GAULAvionique/Cetautomatix/Hardware/Composants/7447715330/WE-PD_1245.step

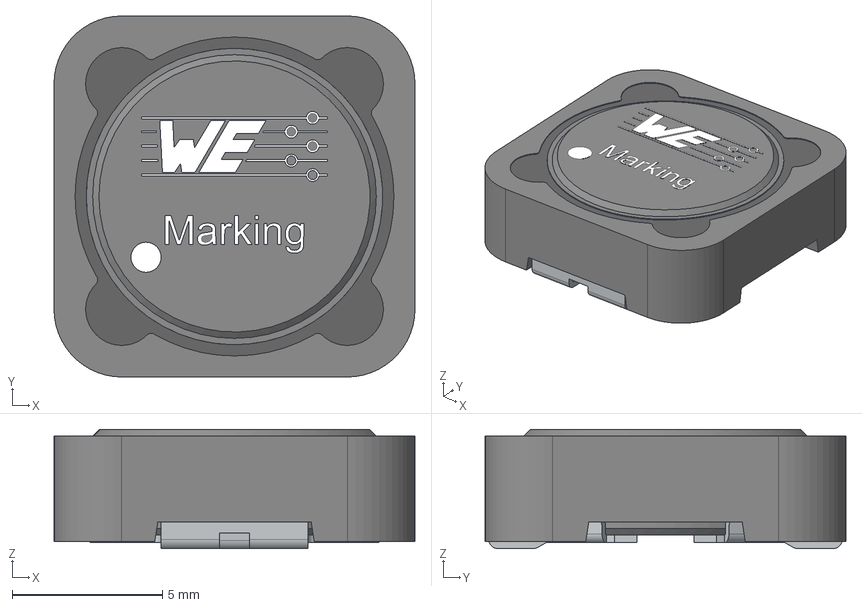
[picture p1: CAD file, 2026-01-22]
Hardware/Composants/7447715330/WE-PD_1245.step
12.0 x 12.0 x 3.96 mm
Core
ShieldRing
Glue
Leadframe
