GAULAvionique/Cetautomatix/Hardware/Composants/GT17HN_4DP_2H_A__56_/GT17HN_4DP_2H_A__56_.stp

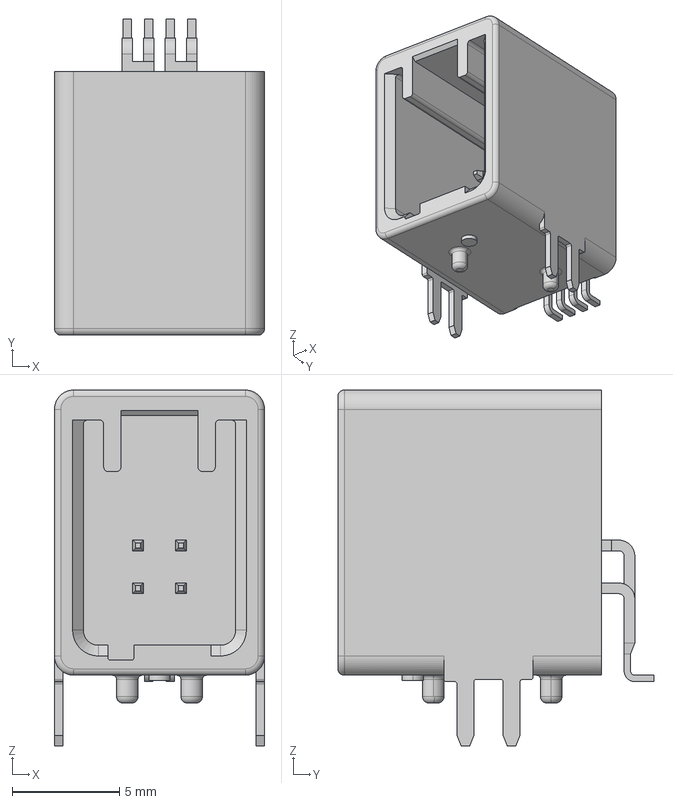
[picture p2: CAD file, 2026-01-23]
Hardware/Composants/GT17HN_4DP_2H_A__56_/GT17HN_4DP_2H_A__56_.stp
9.80 x 14.8 x 16.6 mm
