GAULAvionique/Cetautomatix/Hardware/Composants/LM2673SX-12_NOPB/LM2673SX-12_NOPB.step

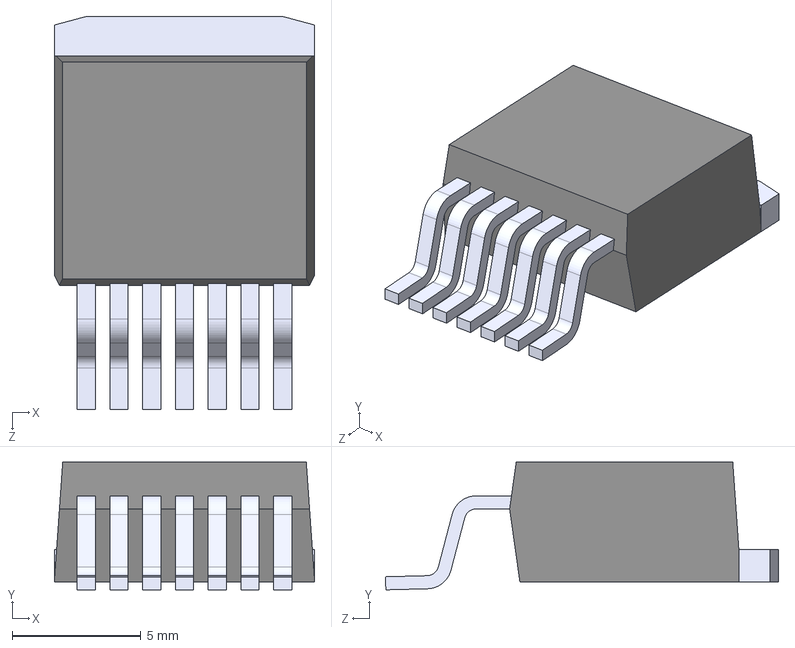
[picture p3: CAD file, 2026-01-25]
Hardware/Composants/LM2673SX-12_NOPB/LM2673SX-12_NOPB.step
10.1 x 4.95 x 15.2 mm
