GAULAvionique/Cetautomatix/Hardware/Composants/MBRS540T3G/MBRS540T3G.step

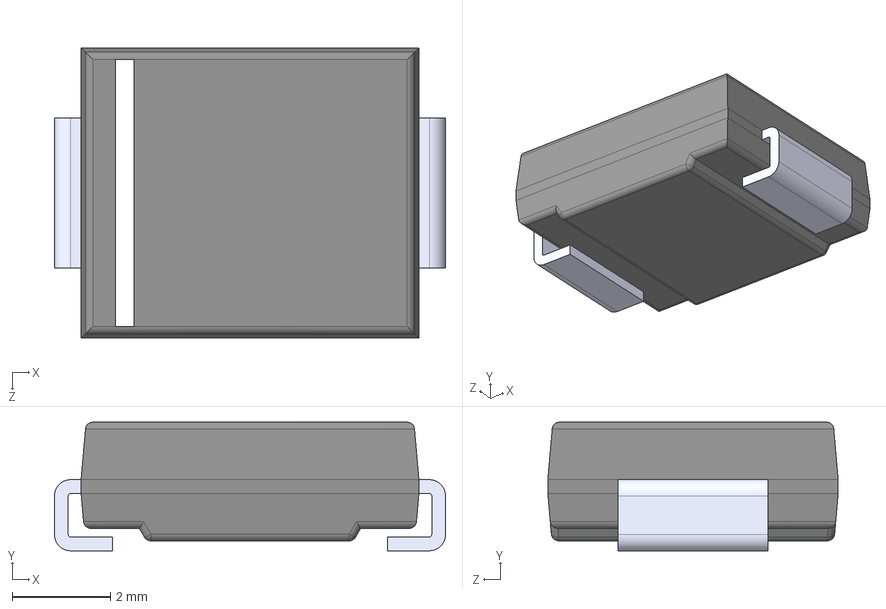
[picture p4: CAD file, 2026-01-26]
Hardware/Composants/MBRS540T3G/MBRS540T3G.step
7.95 x 2.62 x 5.91 mm
