GAULAvionique/Cetautomatix/Hardware/Composants/PJ-037BH/PJ-037BH.step

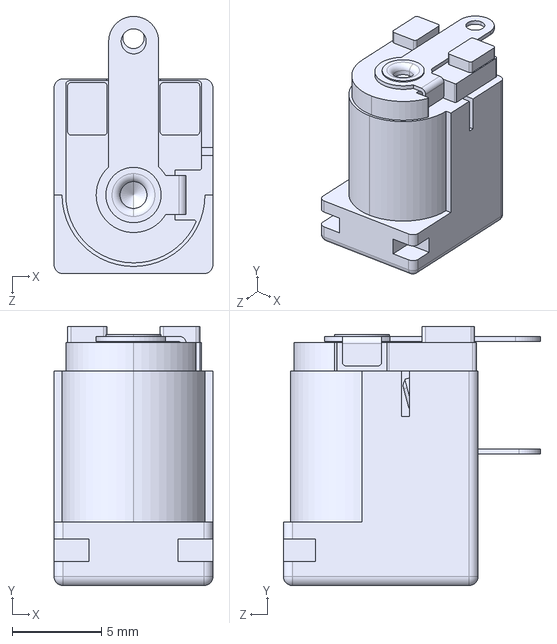
[picture p5: CAD file, 2026-03-07]
Hardware/Composants/PJ-037BH/PJ-037BH.step
8.90 x 14.5 x 14.4 mm
