GAULAvionique/Cetautomatix/Hardware/PCB_GSE/Composants/mod3D/WE-XTAL_HC49.step

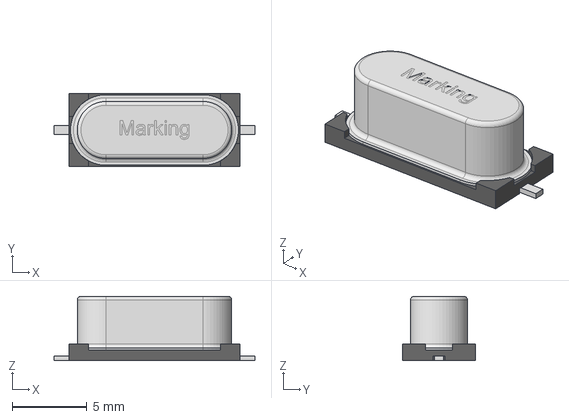
[picture p6: CAD file, 2026-03-09]
Hardware/PCB_GSE/Composants/mod3D/WE-XTAL_HC49.step
13.4 x 4.90 x 4.30 mm
Base
Housing
