GAULAvionique/Cetautomatix/Hardware/PCB_Moteur/Composants/mod3D/SM03B-GHS-TB.step

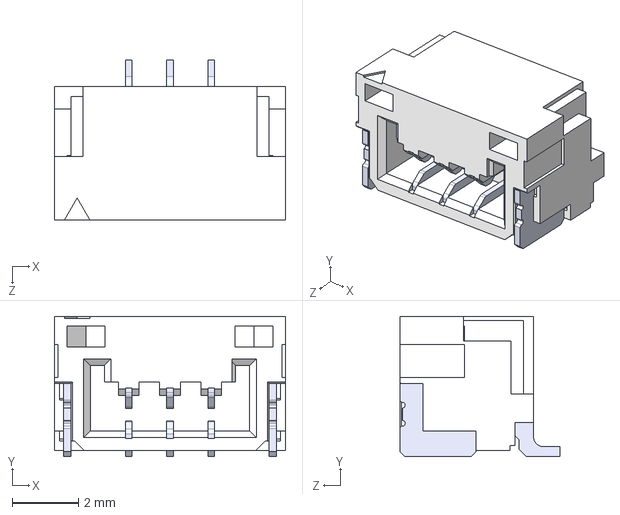
[picture p7: CAD file, 2026-03-08]
Hardware/PCB_Moteur/Composants/mod3D/SM03B-GHS-TB.step
7.00 x 4.25 x 4.85 mm
SMxB-GHS-TB_03
pin x 3
