GAULAvionique/Cetautomatix/Hardware/PCB_Moteur/Composants/mod3D/OSTVN04A150.STEP

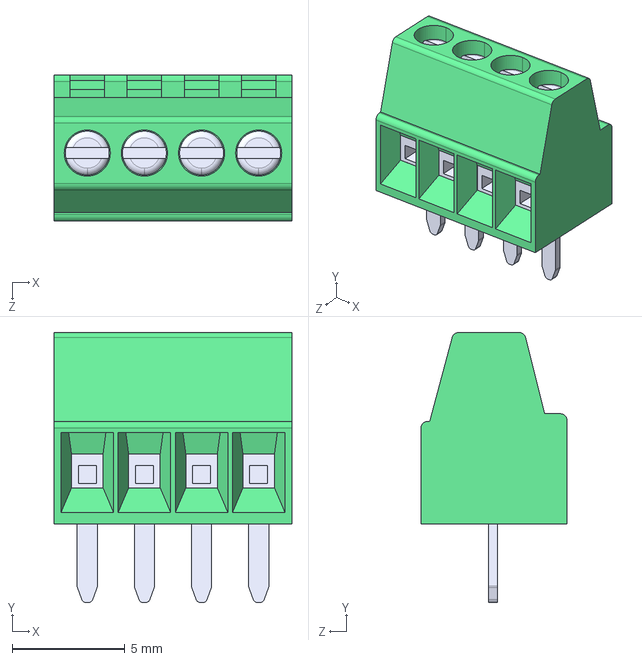
[picture p8: CAD file, 2026-03-06]
Hardware/PCB_Moteur/Composants/mod3D/OSTVN04A150.STEP
10.6 x 12.0 x 6.50 mm
