GAULAvionique/Cetautomatix/Hardware/PCB_GSE/Composants/mod3D/srr1208.stp

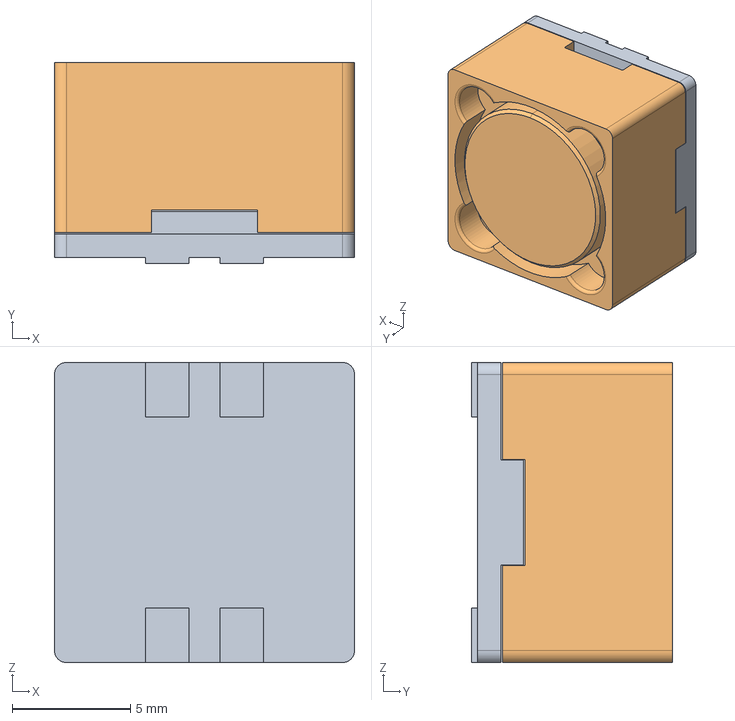
[picture p9: CAD file, 2026-02-07]
Hardware/PCB_GSE/Composants/mod3D/srr1208.stp
12.7 x 8.50 x 12.7 mm
