GAULAvionique/Cetautomatix/Hardware/PCB_GSE/Composants/mod3D/BM03B-GHS-TBT.STEP

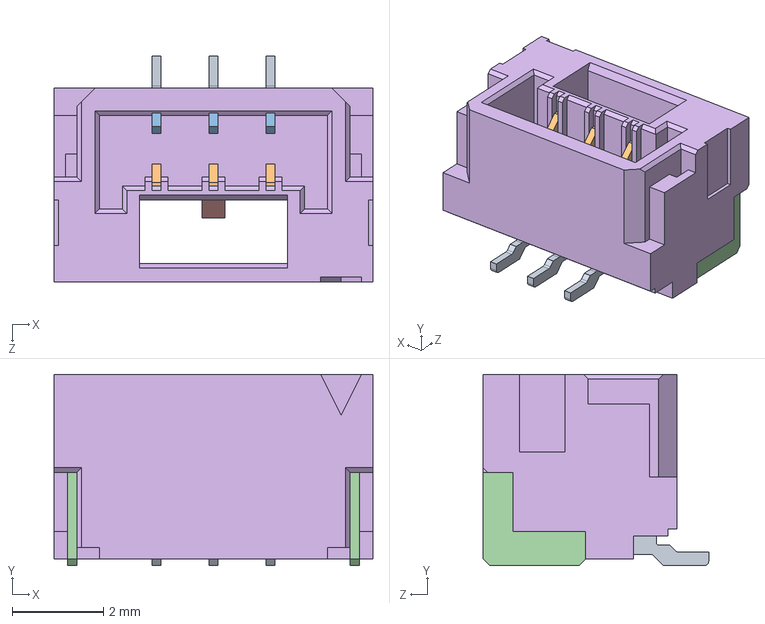
[picture p10: CAD file, 2026-01-21]
Hardware/PCB_GSE/Composants/mod3D/BM03B-GHS-TBT.STEP
7.00 x 4.20 x 4.95 mm
