GAULAvionique/Cetautomatix/Hardware/Composants/830050510/830050510.step

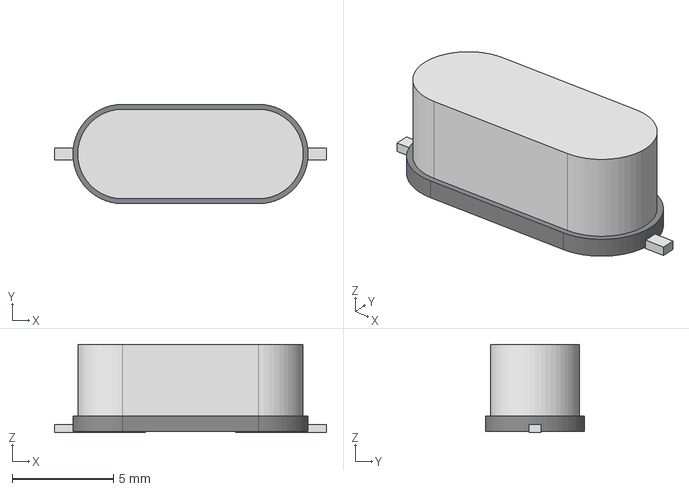
[picture p11: CAD file, 2026-02-06]
Hardware/Composants/830050510/830050510.step
13.4 x 4.90 x 4.34 mm
