GAULAvionique/Cetautomatix/Hardware/Composants/TLV75733PDBVR/TLV75733PDBVR.step

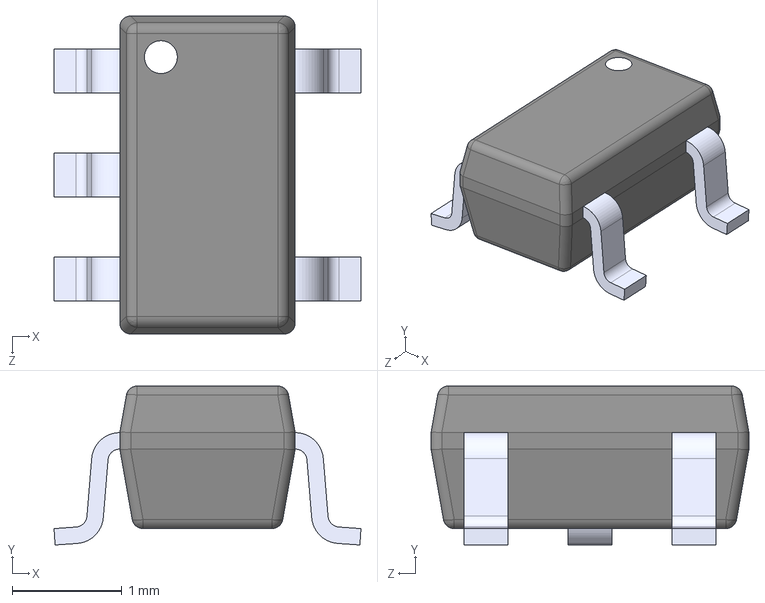
[picture p12: CAD file, 2026-01-27]
Hardware/Composants/TLV75733PDBVR/TLV75733PDBVR.step
2.80 x 1.45 x 2.90 mm
