GAULAvionique/Cetautomatix/Hardware/PCB_GSE/Composants/mod3D/640454-2.step

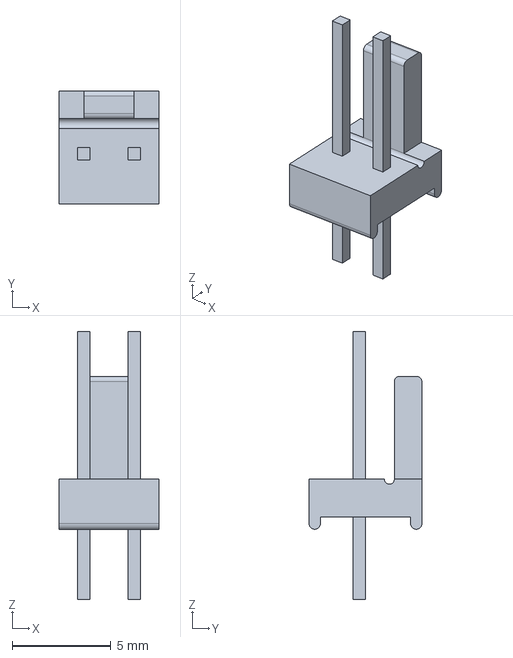
[picture p13: CAD file, 2026-01-19]
Hardware/PCB_GSE/Composants/mod3D/640454-2.step
5.08 x 5.72 x 13.6 mm
