GAULAvionique/Cetautomatix/Hardware/PCB_GSE/Composants/mod3D/2189890210.stp

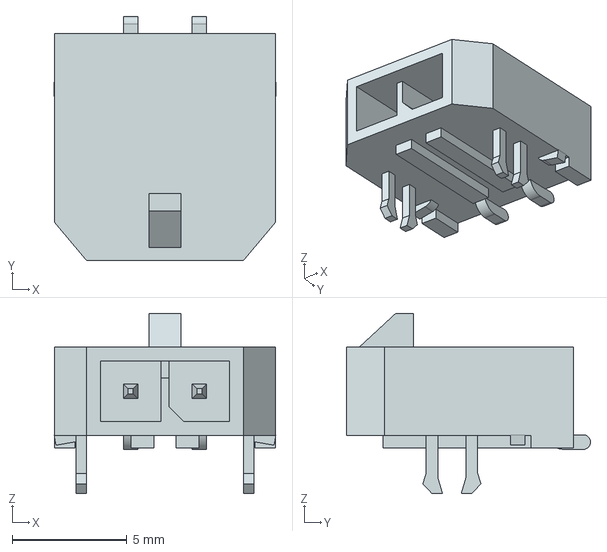
[picture p14: CAD file, 2026-01-19]
Hardware/PCB_GSE/Composants/mod3D/2189890210.stp
9.68 x 10.7 x 7.87 mm
