GAULAvionique/Cetautomatix/(list of files, drawings)

Other design files:
Hardware/PCB_Moteur/PCB_moteur.kicad_pcb.hierpcb.json
