GAULAvionique/Cetautomatix/Hardware/PCB_Moteur/PCB_moteur.kicad_pcb

## KiCad design Hardware/PCB_Moteur/PCB_moteur.kicad_pcb (2026-03-10)

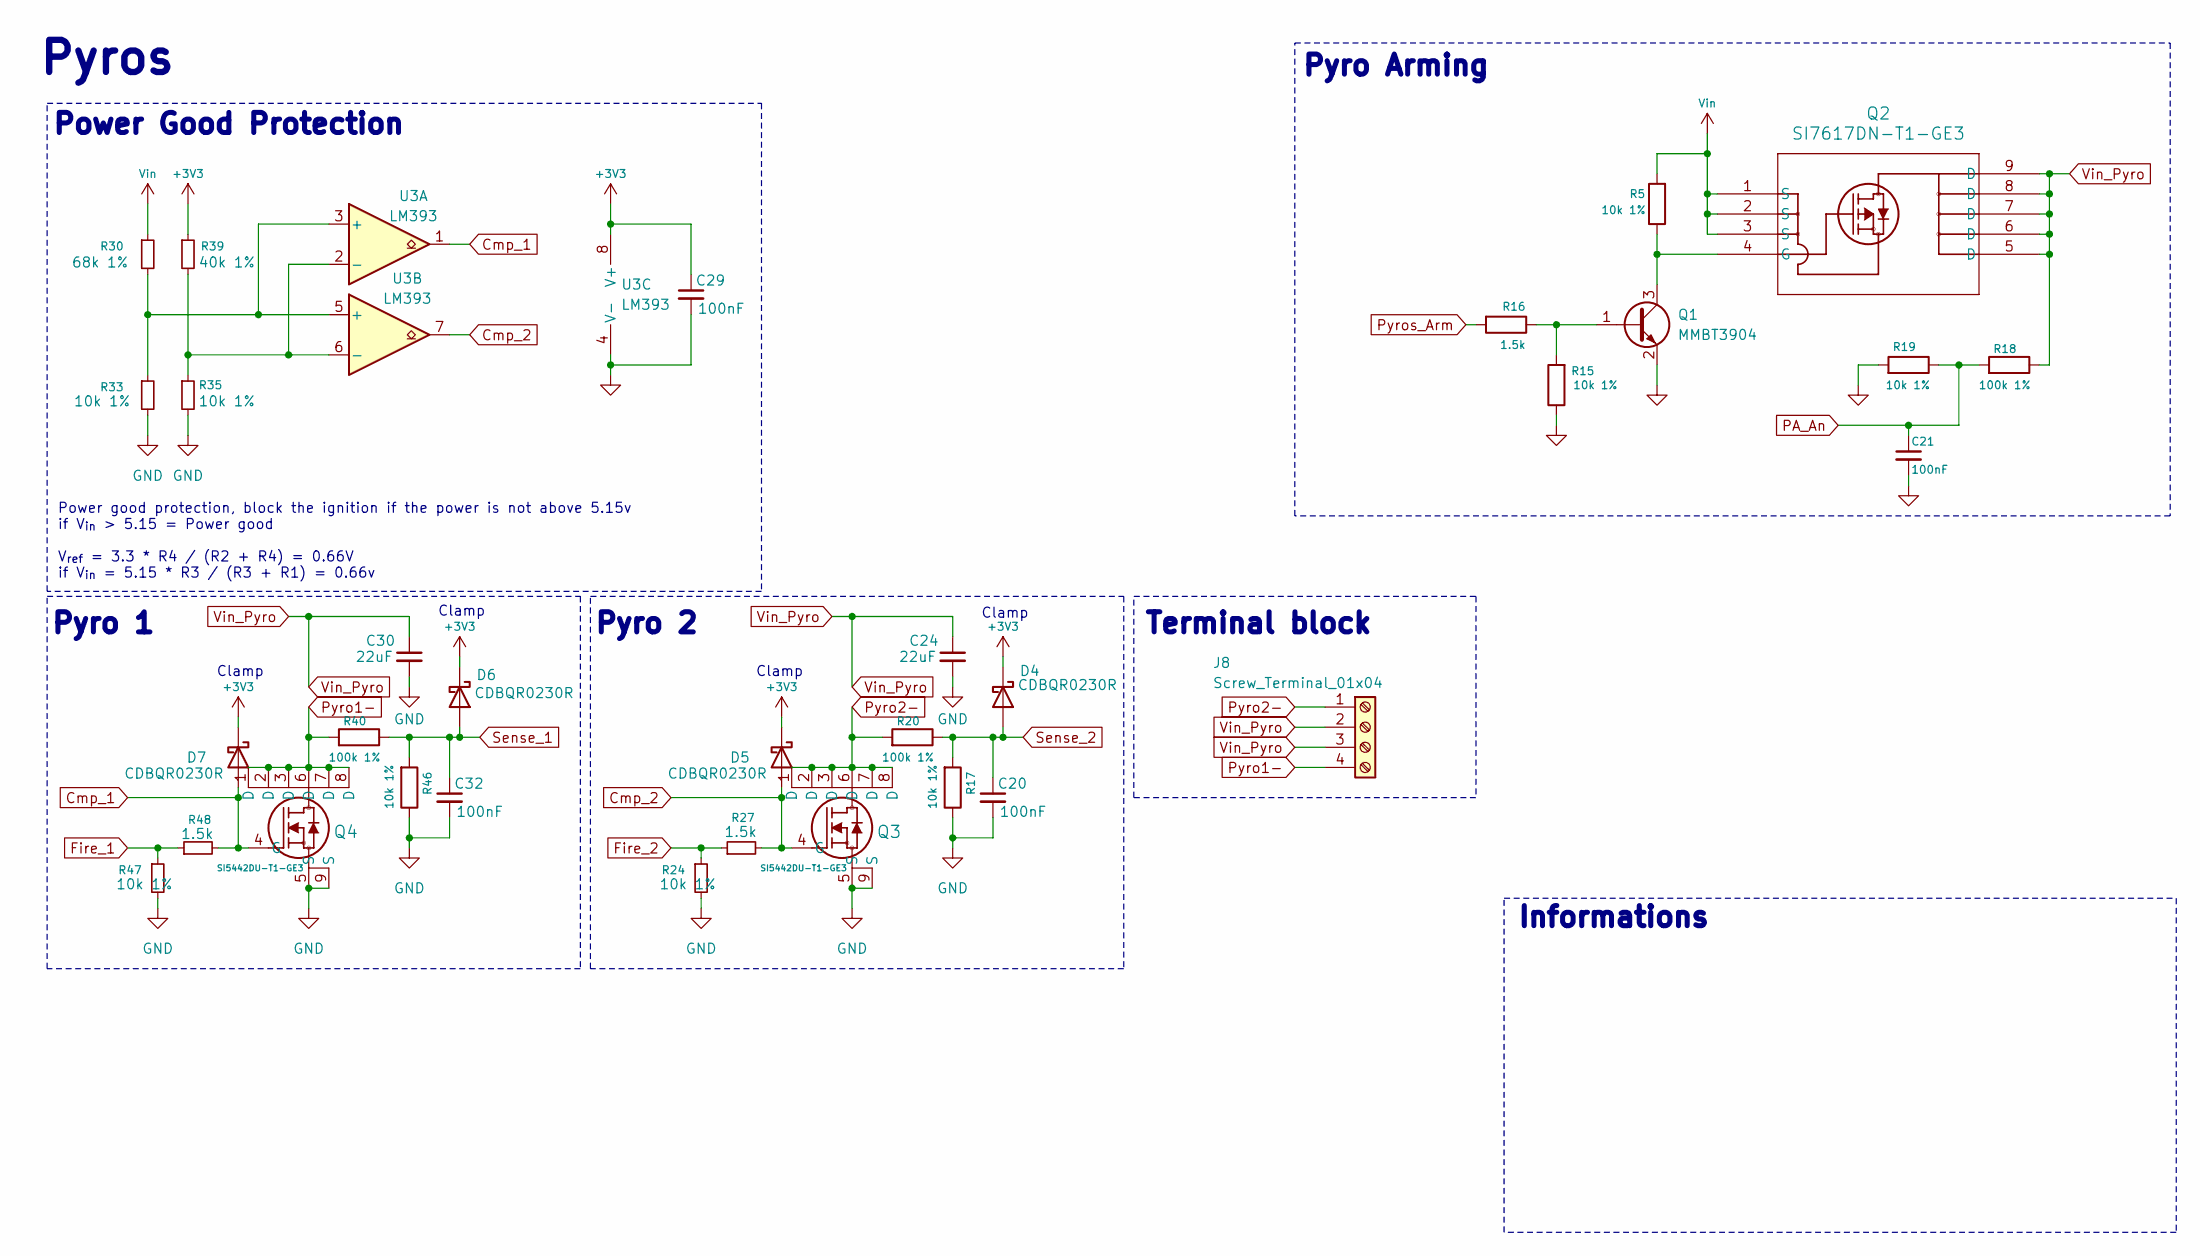
[picture p15: schematic Pyros.kicad_sch]

Parts:
C20, C21, C29, C32: 100nF; C_0805_2012Metric; Manufacturer_Part_Number C0805C104K5RACTU; DigiKey_Part_Number 399-C0805C104K5RACTUCT-ND
C24, C30: 22uF; C_0805_2012Metric; Manufacturer_Part_Number C2012X5R1V226M125AC; DigiKey_Part_Number 445-14428-1-ND
D4, D5, D6, D7: CDBQR0230R; D_0603_1608Metric; Manufacturer_Part_Number CD0603-B0340R; DigiKey_Part_Number CD0603-B0340RCT-ND
J8: Screw_Terminal_01x04; CONN_OSTVN04A150_OST; Manufacturer_Part_Number OSTVN04A150; DigiKey_Part_Number ED10563-ND
Q1: MMBT3904; SOT-23; Manufacturer_Part_Number MMBT3904LT1G; DigiKey_Part_Number MMBT3904LT1GOSCT-ND
Q2: SI7617DN-T1-GE3; POWERPAK_1212-8_VIS; Manufacturer_Part_Number SI7617DN-T1-GE3; DigiKey_Part_Number SI7617DN-T1-GE3CT-ND
Q3, Q4: SI5442DU-T1-GE3; SON_8DU-T1-GE3_VIS; Manufacturer_Part_Number SI5442DU-T1-GE3; DigiKey_Part_Number SI5442DU-T1-GE3CT-ND
R5, R15, R17, R19, R24, R33, R35, R46, R47: 10k 1%; R_0805_2012Metric; Manufacturer_Part_Number CRCW080510K0FKEA; DigiKey_Part_Number 541-10.0KCCT-ND
R16, R27, R48: 1.5k; R_0805_2012Metric; Manufacturer_Part_Number RC0805FR-071K5L; DigiKey_Part_Number 311-1.50KCRCT-ND
R18, R20, R40: 100k 1%; R_0805_2012Metric; Manufacturer_Part_Number RC0805FR-07100KL; DigiKey_Part_Number 311-100KCRCT-ND
R30: 68k 1%; R_0805_2012Metric; Manufacturer_Part_Number RMCF0805FT68K0; DigiKey_Part_Number RMCF0805FT68K0CT-ND
R39: 40k 1%; R_0805_2012Metric; Manufacturer_Part_Number CRCW080540K0FKEA; DigiKey_Part_Number 541-CRCW080540K0FKEACT-ND
U3: LM393; SOIC-8_3.9x4.9mm_P1.27mm; Manufacturer_Part_Number LM393DR; DigiKey_Part_Number 296-1015-1-ND

Connections:
3V3_Main: C29.1, D4.1 (K), D5.1 (K), D6.1 (K), D7.1 (K), R39.1, U3.8 (V+); also elsewhere on the board
Cmp_1: D7.2 (A), Q4.4 (G), R48.2, U3.1
Cmp_2: D5.2 (A), Q3.4 (G), R27.2, U3.7
Fire_1: R47.1, R48.1; also elsewhere on the board
Fire_2: R24.1, R27.1; also elsewhere on the board
GND: C20.2, C21.2, C24.2, C29.2, C30.2, C32.2, Q1.2 (E), Q3.5 (S), Q3.9 (S), Q4.5 (S), Q4.9 (S), R15.1, R17.1, R19.2, R24.2, R33.2, R35.2, R46.1, R47.2, U3.4 (V-); also elsewhere on the board
unnamed: Q1.1 (B), R15.2, R16.1
unnamed: Q1.3 (C), Q2.4 (G), R5.1
unnamed: R30.2, R33.1, U3.3 (+), U3.5 (+)
unnamed: R35.1, R39.2, U3.2 (-), U3.6 (-)
PA_An: C21.1, R18.2, R19.1; also elsewhere on the board
Pyro1-: J8.4, Q4.1 (D), Q4.2 (D), Q4.3 (D), Q4.6 (D), Q4.7 (D), Q4.8 (D), R40.2
Pyro2-: J8.1, Q3.1 (D), Q3.2 (D), Q3.3 (D), Q3.6 (D), Q3.7 (D), Q3.8 (D), R20.2
Pyros_Arm: R16.2; also elsewhere on the board
Sense_1: C32.1, D6.2 (A), R40.1, R46.2; also elsewhere on the board
Sense_2: C20.1, D4.2 (A), R17.2, R20.1; also elsewhere on the board
VIN_Filtered: Q2.1 (S), Q2.2 (S), Q2.3 (S), R5.2, R30.1; also elsewhere on the board
Vin_Pyro: C24.1, C30.1, J8.2, J8.3, Q2.5 (D), Q2.6 (D), Q2.7 (D), Q2.8 (D), Q2.9 (D), R18.1

Notes on the sheet:
Power good protection, block the ignition if the power is not above 5.15v if V_{in} > 5.15 = Power good V_{ref} = 3.3 * R4 / (R2 + R4) = 0.66V if V_{in} = 5.15 * R3 / (R3 + R1) = 0.66v
Clamp
Pyro 1
Terminal block
Pyro Arming
Pyros
Informations
Power Good Protection
Pyro 2

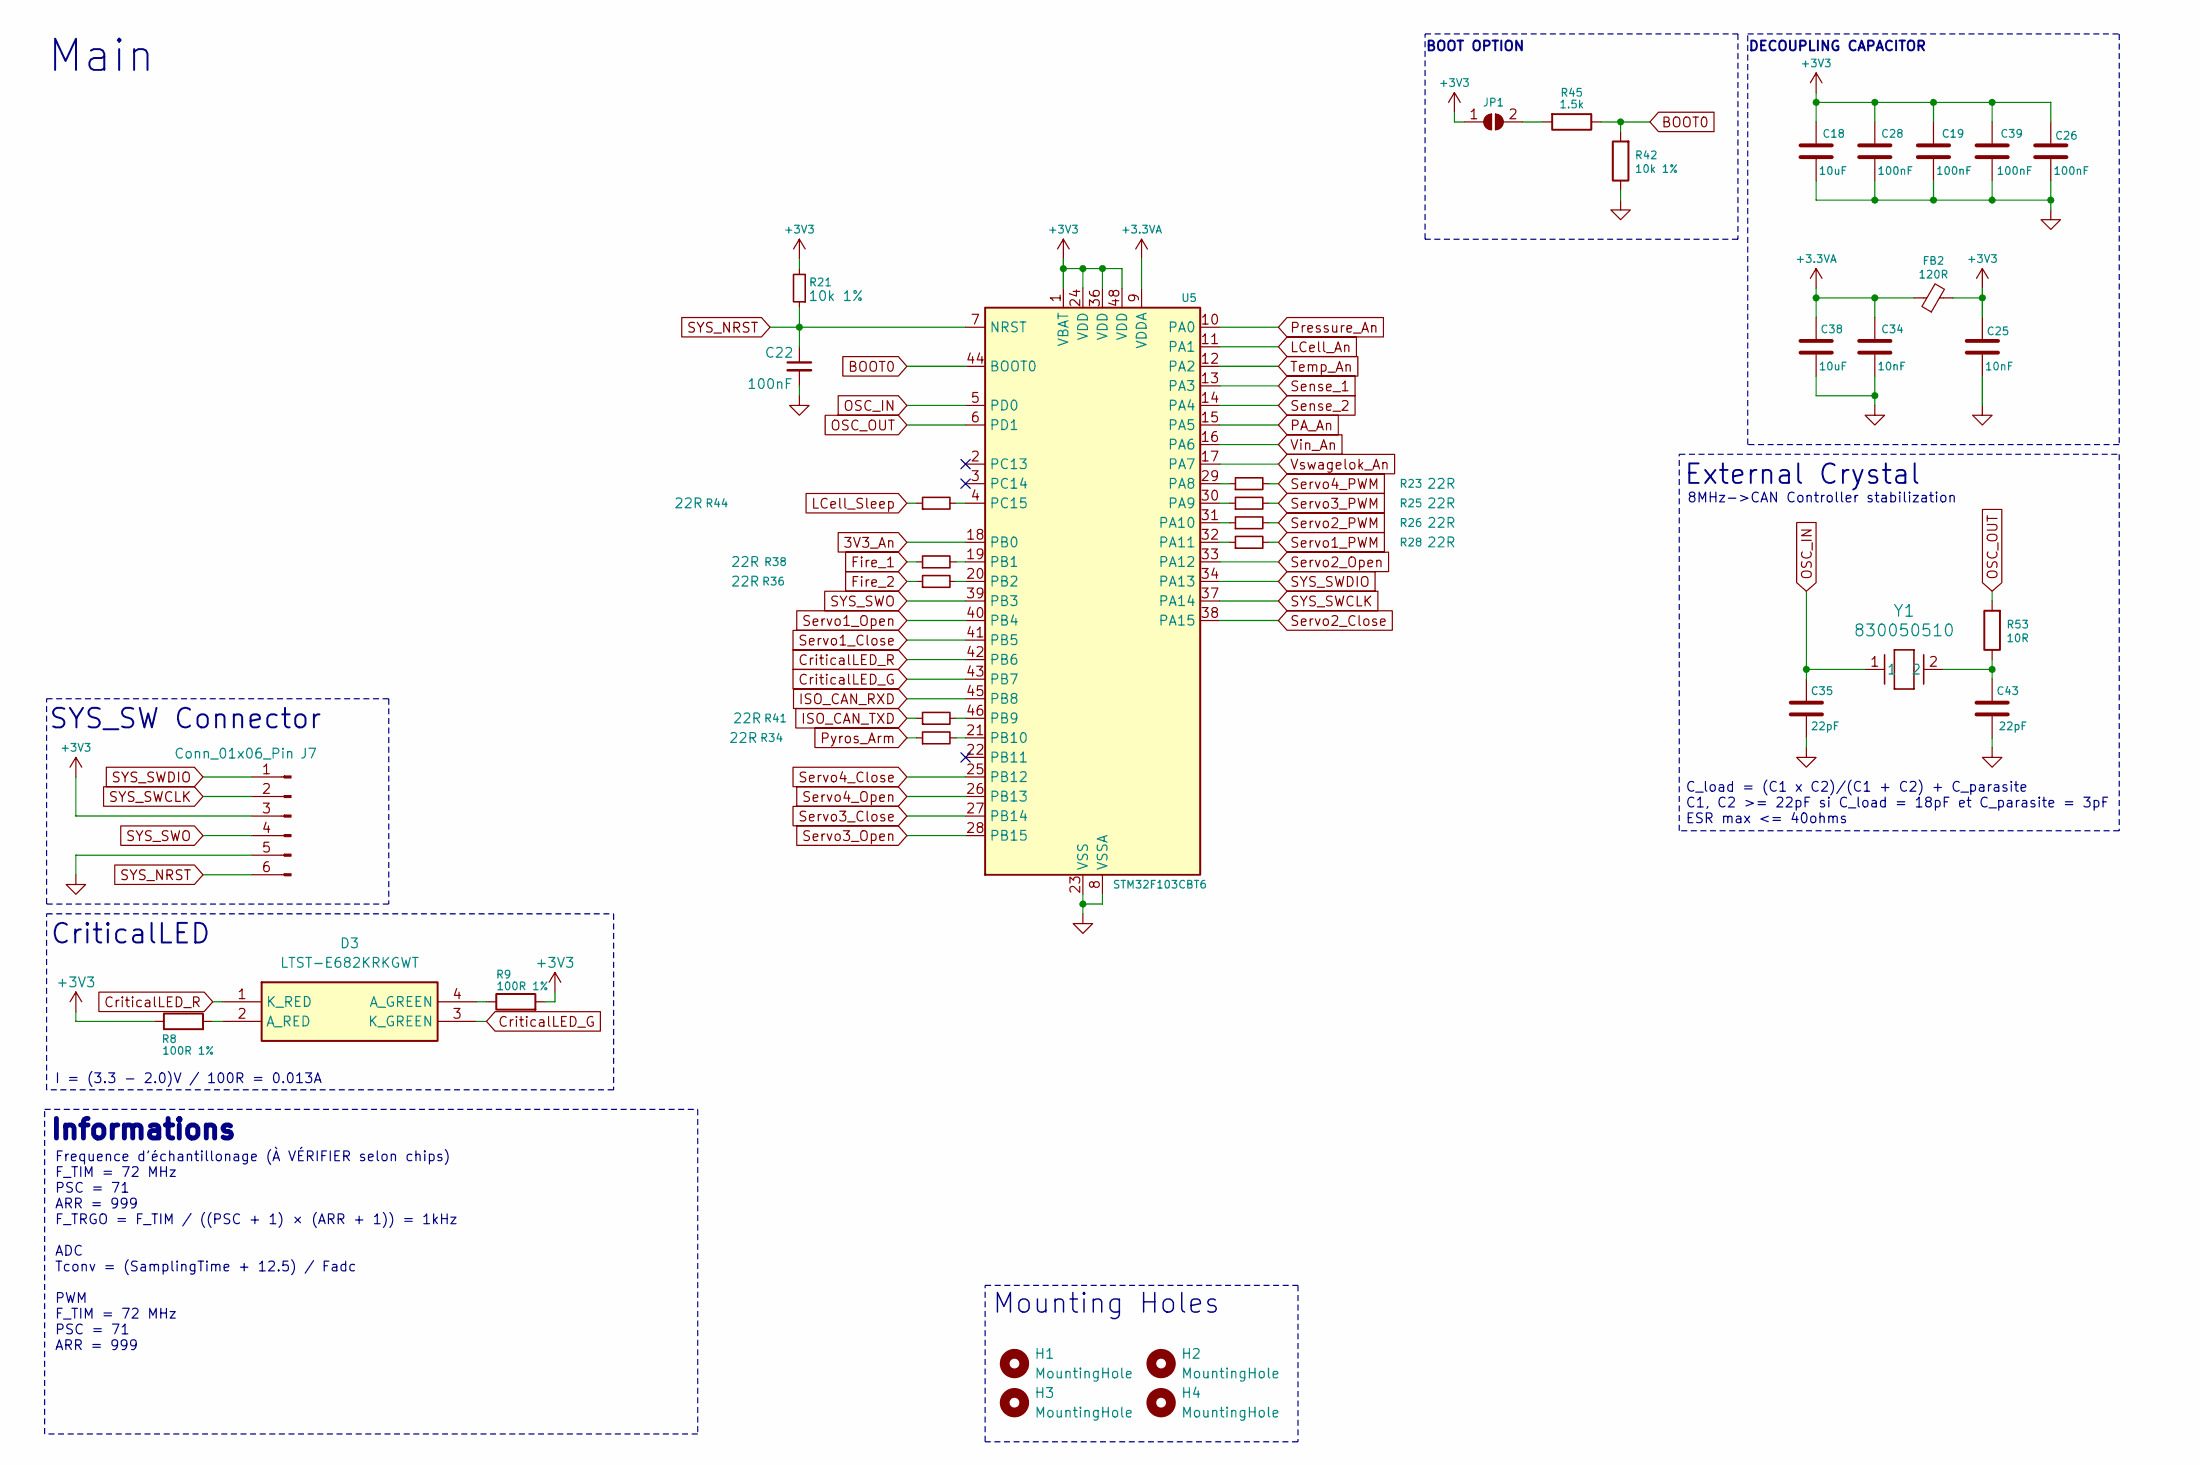
[picture p16: schematic STM32_moteur.kicad_sch]

Parts:
C18, C38: 10uF; C_0805_2012Metric; Manufacturer_Part_Number CL21A106KAYNNNE; DigiKey_Part_Number 1276-2891-1-ND
C19, C22, C26, C28, C39: 100nF; C_0805_2012Metric; Manufacturer_Part_Number C0805C104K5RACTU; DigiKey_Part_Number 399-C0805C104K5RACTUCT-ND
C25, C34: 10nF; C_0603_1608Metric; Manufacturer_Part_Number C0603C103K5RACTU; DigiKey_Part_Number 399-C0603C103K5RACTUCT-ND
C35, C43: 22pF; C_0805_2012Metric; Manufacturer_Part_Number QSCT251Q220F1GV001E; DigiKey_Part_Number 712-QSCT251Q220F1GV001ECT-ND
D3: LTST-E682KRKGWT; LTSTE683RGBW; Mouser Part Number 859-LTST-E682KRKGWT
FB2: 120R; L_0805_2012Metric; Manufacturer_Part_Number 2508051217Y6; DigiKey_Part_Number 1934-1472-1-ND
H1, H2, H3, H4: MountingHole; MountingHole_4.3mm_M4
J7: Conn_01x06_Pin; PinHeader_1x06_P2.54mm_Vertical; Manufacturer_Part_Number 61300611121; DigiKey_Part_Number 732-5319-ND
JP1: SolderJumper_2_Open; SolderJumper-2_P1.3mm_Open_TrianglePad1.0x1.5mm
R8, R9: 100R 1%; R_0805_2012Metric; Manufacturer_Part_Number YAG3360CT-ND; DigiKey_Part_Number RT0805FRE07100RL
R21, R42: 10k 1%; R_0805_2012Metric; Manufacturer_Part_Number CRCW080510K0FKEA; DigiKey_Part_Number 541-10.0KCCT-ND
R23, R25, R26, R28, R34, R36, R38, R41, R44: 22R; R_0603_1608Metric; Manufacturer_Part_Number ESR03EZPJ220; DigiKey_Part_Number RHM22DCT-ND
R45: 1.5k; R_0805_2012Metric; Manufacturer_Part_Number RC0805FR-071K5L; DigiKey_Part_Number 311-1.50KCRCT-ND
R53: 10R; R_0805_2012Metric; Manufacturer_Part_Number RC0805FR-0710RL; DigiKey_Part_Number 311-10.0CRCT-ND
U5: STM32F103CBT6; LQFP-48_7x7mm_P0.5mm; Manufacturer_Part_Number STM32F103CBT6; DigiKey_Part_Number 497-6288-ND
Y1: 830050510; Manufacturer_Part_Number 830050510; DigiKey_Part_Number 1923-830050510CT-ND

Connections:
3V3_An: U5.18 (PB0); also elsewhere on the board
3V3_Main: C18.2, C19.2, C25.2, C26.2, C28.2, C39.2, FB2.2, J7.3, JP1.1 (A), R8.1, R9.2, R21.2, U5.1 (VBAT), U5.24 (VDD), U5.36 (VDD), U5.48 (VDD); also elsewhere on the board
+3.3VA: C34.2, C38.2, FB2.1, U5.9 (VDDA)
BOOT0: R42.2, R45.1, U5.44 (BOOT0)
CriticalLED_G: D3.3 (K_GREEN), U5.43 (PB7)
CriticalLED_R: D3.1 (K_RED), U5.42 (PB6)
Fire_1: R38.1; also elsewhere on the board
Fire_2: R36.1; also elsewhere on the board
GND: C18.1, C19.1, C22.2, C25.1, C26.1, C28.1, C34.1, C35.1, C38.1, C39.1, C43.1, J7.5, R42.1, U5.8 (VSSA), U5.23 (VSS), U5.35 (VSS), U5.47 (VSS); also elsewhere on the board
ISO_CAN_RXD: U5.45 (PB8); also elsewhere on the board
ISO_CAN_TXD: R41.1; also elsewhere on the board
LCell_An: U5.11 (PA1); also elsewhere on the board
LCell_Sleep: R44.1; also elsewhere on the board
unnamed: C43.2, R53.1, Y1.2
unnamed: D3.4 (A_GREEN), R9.1
unnamed: D3.2 (A_RED), R8.2
unnamed: JP1.2 (B), R45.2
unnamed: R23.1, U5.29 (PA8)
unnamed: R25.1, U5.30 (PA9)
unnamed: R26.1, U5.31 (PA10)
unnamed: R28.1, U5.32 (PA11)
unnamed: R38.2, U5.19 (PB1)
unnamed: R36.2, U5.20 (PB2)
unnamed: R41.2, U5.46 (PB9)
unnamed: R34.2, U5.21 (PB10)
unnamed: R44.2, U5.4 (PC15)
OSC_IN: C35.2, U5.5 (PD0), Y1.1
OSC_OUT: R53.2, U5.6 (PD1)
PA_An: U5.15 (PA5); also elsewhere on the board
Pressure_An: U5.10 (PA0); also elsewhere on the board
Pyros_Arm: R34.1; also elsewhere on the board
SYS_NRST: C22.1, J7.6, R21.1, U5.7 (NRST)
SYS_SWCLK: J7.2, U5.37 (PA14)
SYS_SWDIO: J7.1, U5.34 (PA13)
SYS_SWO: J7.4, U5.39 (PB3)
Sense_1: U5.13 (PA3); also elsewhere on the board
Sense_2: U5.14 (PA4); also elsewhere on the board
Servo1_Close: U5.41 (PB5); also elsewhere on the board
Servo1_Open: U5.40 (PB4); also elsewhere on the board
Servo1_PWM: R28.2; also elsewhere on the board
Servo2_Close: U5.38 (PA15); also elsewhere on the board
Servo2_Open: U5.33 (PA12); also elsewhere on the board
Servo2_PWM: R26.2; also elsewhere on the board
Servo3_Close: U5.27 (PB14); also elsewhere on the board
Servo3_Open: U5.28 (PB15); also elsewhere on the board
Servo3_PWM: R25.2; also elsewhere on the board
Servo4_Close: U5.25 (PB12); also elsewhere on the board
Servo4_Open: U5.26 (PB13); also elsewhere on the board
Servo4_PWM: R23.2; also elsewhere on the board
Temp_An: U5.12 (PA2); also elsewhere on the board
Vin_An: U5.16 (PA6); also elsewhere on the board
Vswagelok_An: U5.17 (PA7); also elsewhere on the board

Notes on the sheet:
External Crystal
Mounting Holes
Main
BOOT OPTION
C_load = (C1 x C2)/(C1 + C2) + C_parasite C1, C2 >= 22pF si C_load = 18pF et C_parasite = 3pF ESR max <= 40ohms
DECOUPLING CAPACITOR
SYS_SW Connector
Informations
CriticalLED
I = (3.3 - 2.0)V / 100R = 0.013A
8MHz->CAN Controller stabilization
Frequence d'échantillonage (À VÉRIFIER selon chips) F_TIM = 72 MHz PSC = 71 ARR = 999 F_TRGO = F_TIM / ((PSC + 1) × (ARR + 1)) = 1kHz ADC Tconv = (SamplingTime + 12.5) / Fadc PWM F_TIM = 72 MHz PSC = 71 ARR = 999

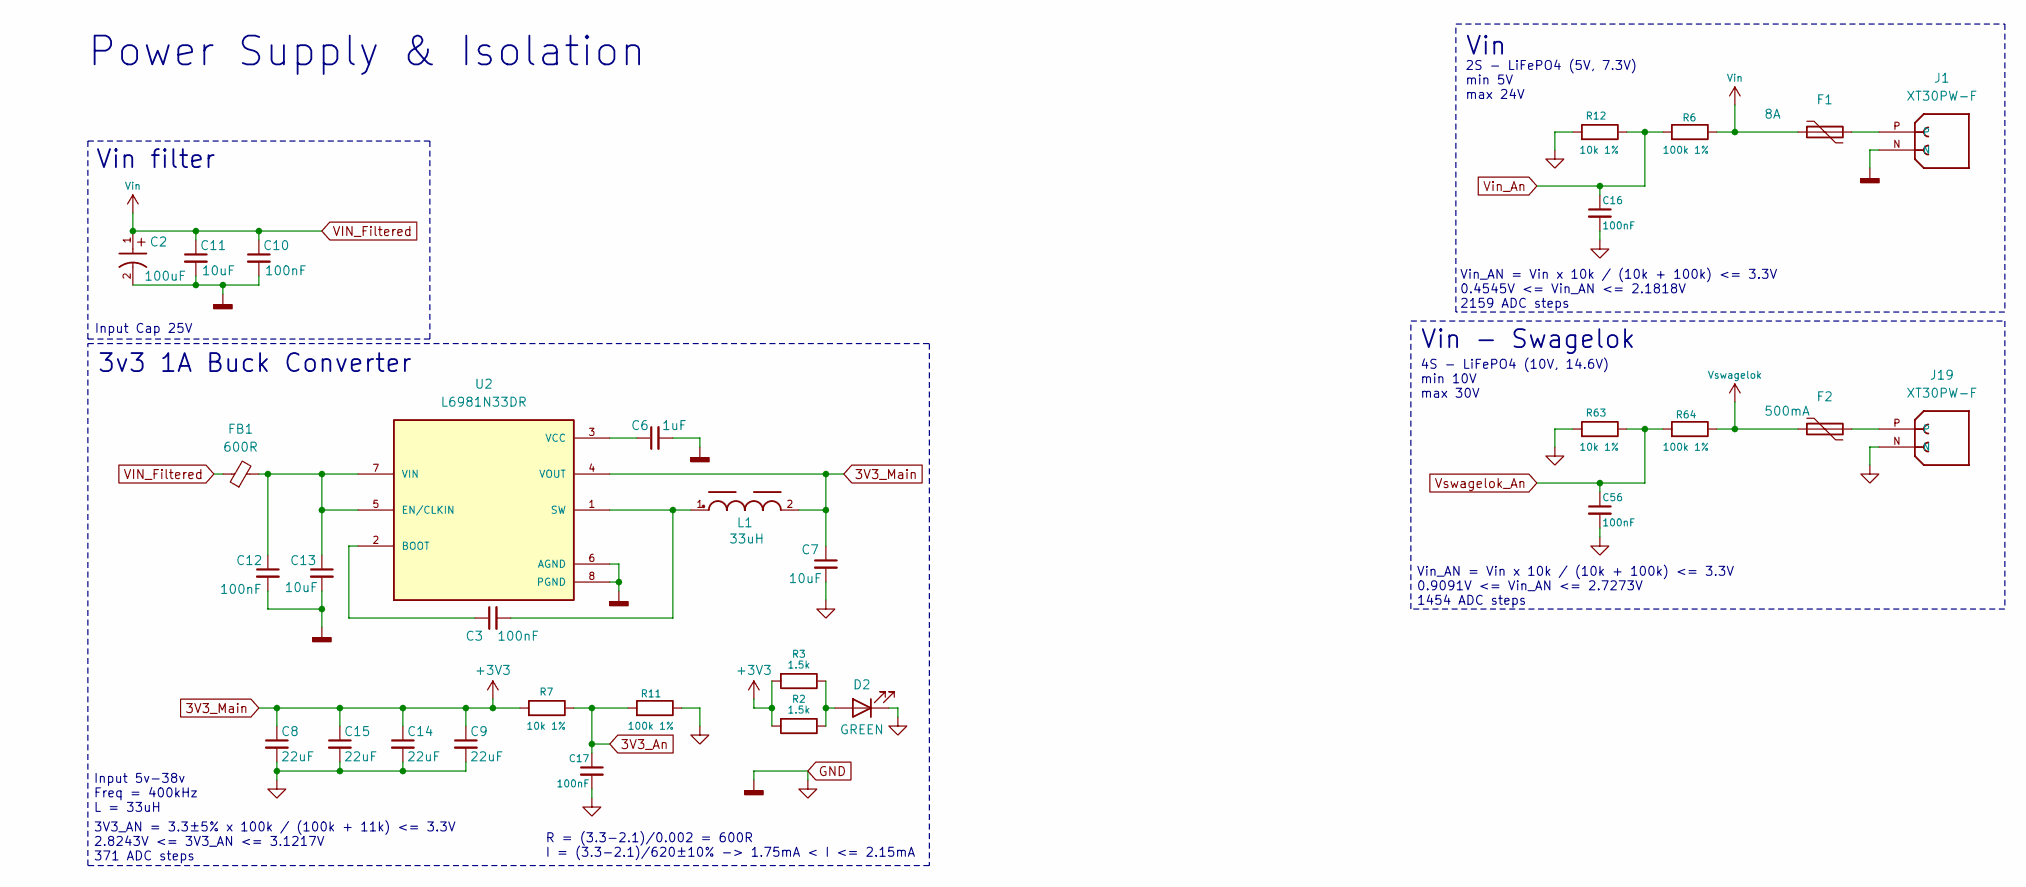
[picture p17: schematic Supply_moteur.kicad_sch]

Parts:
C2: 100uF; CP_Radial_D6.3mm_P2.50mm; Manufacturer_Part_Number 860040573004; DigiKey_Part_Number 732-9215-1-ND
C3, C10, C12, C16, C17, C56: 100nF; C_0805_2012Metric; Manufacturer_Part_Number C0805C104K5RACTU; DigiKey_Part_Number 399-C0805C104K5RACTUCT-ND
C6: 1uF; C_0805_2012Metric; Manufacturer_Part_Number CL21B105KBFNNNE; DigiKey_Part_Number 1276-1029-1-ND
C7, C11, C13: 10uF; C_0805_2012Metric; Manufacturer_Part_Number CL21A106KAYNNNE; DigiKey_Part_Number 1276-2891-1-ND
C8, C9, C14, C15: 22uF; C_0805_2012Metric; Manufacturer_Part_Number C2012X5R1V226M125AC; DigiKey_Part_Number 445-14428-1-ND
D2: GREEN; LED_QBLP601-AG15; Manufacturer_Part_Number QBLP601-AG15; DigiKey_Part_Number 1516-QBLP601-AG15CT-ND
F1: 8A; Fuse_2920_7451Metric; Manufacturer_Part_Number 2920L400/15MR; DigiKey_Part_Number F8136CT-ND
F2: 500mA; Fuse_0805_2012Metric; Manufacturer_Part_Number 0805L020/24YR; DigiKey_Part_Number 18-0805L020/24YRCT-ND
FB1: 600R; L_1210_3225Metric; Manufacturer_Part_Number FBMH3225HM601NT; DigiKey_Part_Number 587-1755-1-ND
J1, J19: XT30PW-F; PARTREV 1.2
L1: 33uH; WE-PD_1245; Manufacturer_Part_Number 7447715330; DigiKey_Part_Number 732-2196-1-ND
R2, R3: 1.5k; R_0805_2012Metric; Manufacturer_Part_Number RC0805FR-071K5L; DigiKey_Part_Number 311-1.50KCRCT-ND
R6, R11, R64: 100k 1%; R_0805_2012Metric; Manufacturer_Part_Number RC0805FR-07100KL; DigiKey_Part_Number 311-100KCRCT-ND
R7, R12, R63: 10k 1%; R_0805_2012Metric; Manufacturer_Part_Number CRCW080510K0FKEA; DigiKey_Part_Number 541-10.0KCCT-ND
U2: L6981N33DR; PARTREV 3; DigiKey_Part_Number 497-L6981N33DRCT-ND

Connections:
3V3_An: C17.1, R7.1, R11.2; also elsewhere on the board
3V3_Main: C7.1, C8.1, C9.1, C14.1, C15.1, L1.2, R2.2, R3.2, R7.2, U2.4 (VOUT); also elsewhere on the board
GND: C2.2, C6.2, C7.2, C8.2, C9.2, C10.2, C11.2, C12.2, C13.2, C14.2, C15.2, C16.2, C17.2, C56.2, D2.1 (K), J1.N, J19.N, R11.1, R12.2, R63.2, U2.6 (AGND), U2.8 (PGND); also elsewhere on the board
unnamed: D2.2 (A), R2.1, R3.1
unnamed: F1.2, J1.P
unnamed: F2.2, J19.P
unnamed: C3.1, U2.2 (BOOT)
unnamed: C12.1, C13.1, FB1.2, U2.5 (EN/CLKIN), U2.7 (VIN)
unnamed: C3.2, L1.1, U2.1 (SW)
unnamed: C6.1, U2.3 (VCC)
VIN_Filtered: C2.1, C10.1, C11.1, F1.1, FB1.1, R6.1; also elsewhere on the board
Vin_An: C16.1, R6.2, R12.1; also elsewhere on the board
Vswagelok: F2.1, R64.1; also elsewhere on the board
Vswagelok_An: C56.1, R63.1, R64.2; also elsewhere on the board

Notes on the sheet:
Vin_AN = Vin x 10k / (10k + 100k) <= 3.3V 0.4545V <= Vin_AN <= 2.1818V 2159 ADC steps
Vin - Swagelok
Input 5v-38v Freq = 400kHz L = 33uH
Vin_AN = Vin x 10k / (10k + 100k) <= 3.3V 0.9091V <= Vin_AN <= 2.7273V 1454 ADC steps
R = (3.3-2.1)/0.002 = 600R I = (3.3-2.1)/620±10% -> 1.75mA < I <= 2.15mA
Power Supply & Isolation
Vin
Vin filter
2S - LiFePO4 (5V, 7.3V) min 5V max 24V
Input Cap 25V
4S - LiFePO4 (10V, 14.6V) min 10V max 30V
3V3_AN = 3.3±5% x 100k / (100k + 11k) <= 3.3V 2.8243V <= 3V3_AN <= 3.1217V 371 ADC steps
3v3 1A Buck Converter

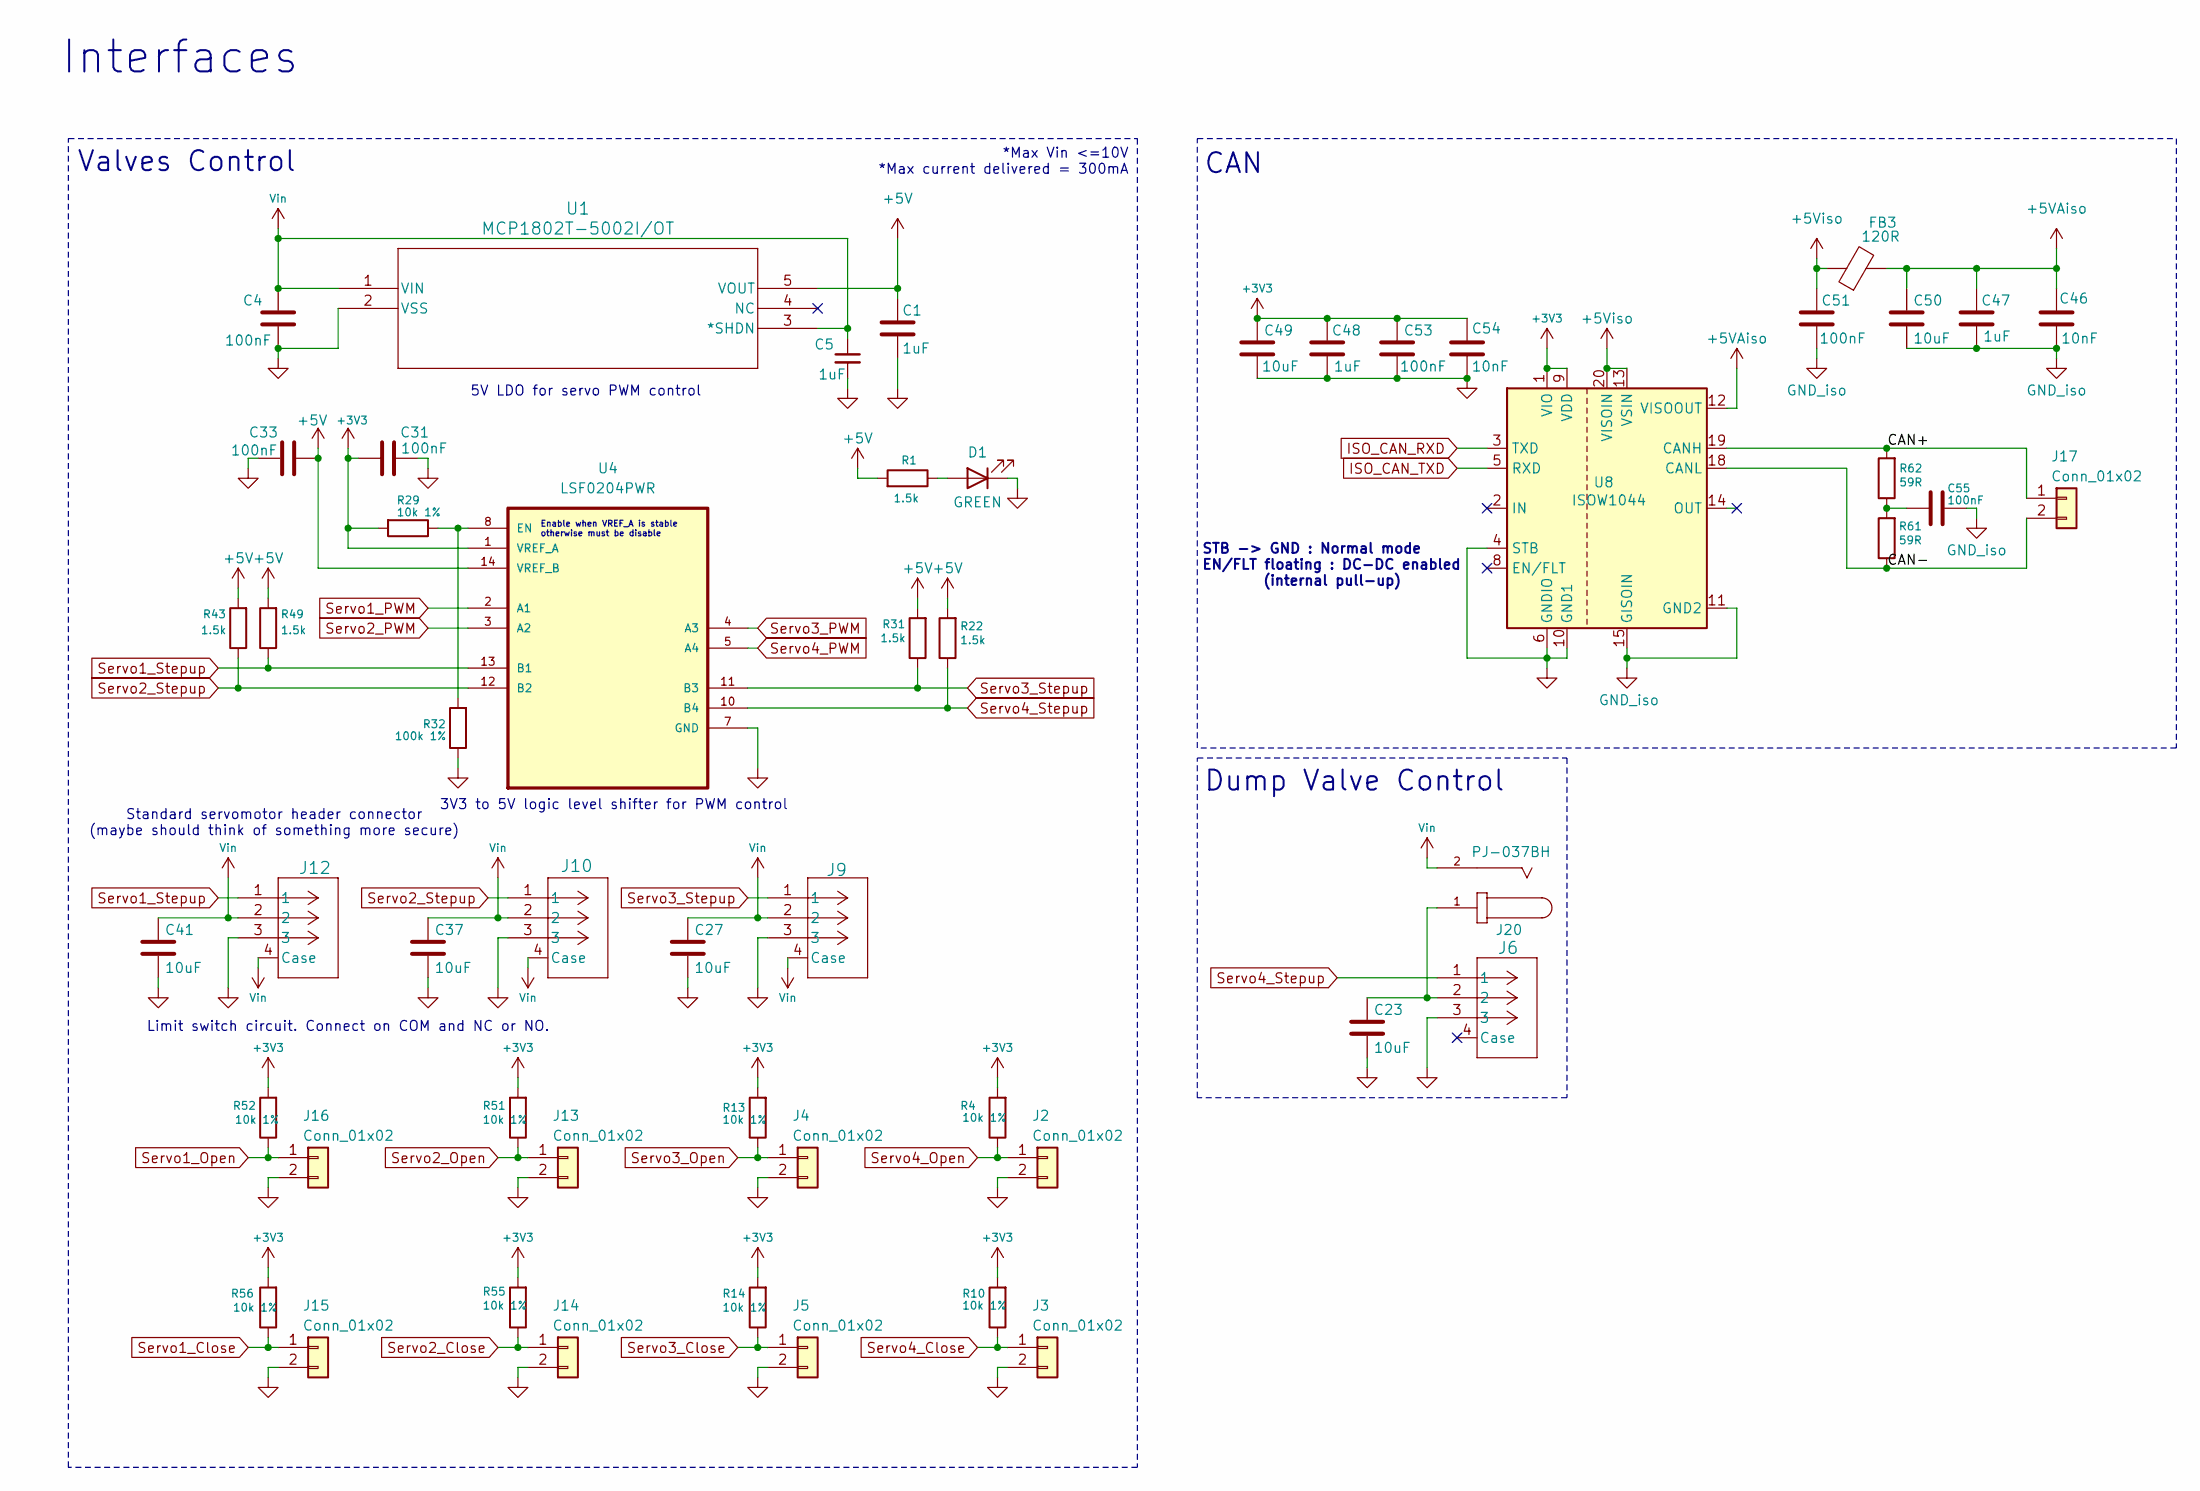
[picture p18: schematic Interfaces_moteur.kicad_sch]

Parts:
C1, C5, C47, C48: 1uF; C_0805_2012Metric; Manufacturer_Part_Number CL21B105KBFNNNE; DigiKey_Part_Number 1276-1029-1-ND
C4, C31, C33, C51, C53, C55: 100nF; C_0805_2012Metric; Manufacturer_Part_Number C0805C104K5RACTU; DigiKey_Part_Number 399-C0805C104K5RACTUCT-ND
C23, C27, C37, C41, C49, C50: 10uF; C_0805_2012Metric; Manufacturer_Part_Number CL21A106KAYNNNE; DigiKey_Part_Number 1276-2891-1-ND
C46, C54: 10nF; C_0603_1608Metric; Manufacturer_Part_Number C0603C103K5RACTU; DigiKey_Part_Number 399-C0603C103K5RACTUCT-ND
D1: GREEN; LED_QBLP601-AG15; Manufacturer_Part_Number QBLP601-AG15; DigiKey_Part_Number 1516-QBLP601-AG15CT-ND
FB3: 120R; L_0805_2012Metric; Manufacturer_Part_Number 2508051217Y6; DigiKey_Part_Number 1934-1472-1-ND
J2, J3, J4, J5, J13, J14, J15, J16: Conn_01x02; TE_640454-2; Manufacturer_Part_Number 640454-2; DigiKey_Part_Number A19423-ND
J6, J9, J10, J12: SM03B-GHS-TB; JST_SM03B-GHS-TB; Manufacturer_Part_Number SM03B-GHS-TB; DigiKey_Part_Number 455-SM03B-GHS-TBCT-ND
J17: Conn_01x02; CONN_2189890010-SD_02_MOL; Manufacturer_Part_Number 2189890210; DigiKey_Part_Number 900-2189890210CT-ND
J20: PJ-037BH; SAMESKY_PJ-037BH; PARTREV 1.08; DigiKey_Part_Number CP-037BH-ND
R1, R22, R31, R43, R49: 1.5k; R_0805_2012Metric; Manufacturer_Part_Number RC0805FR-071K5L; DigiKey_Part_Number 311-1.50KCRCT-ND
R4, R10, R13, R14, R29, R51, R52, R55, R56: 10k 1%; R_0805_2012Metric; Manufacturer_Part_Number CRCW080510K0FKEA; DigiKey_Part_Number 541-10.0KCCT-ND
R32: 100k 1%; R_0805_2012Metric; Manufacturer_Part_Number RC0805FR-07100KL; DigiKey_Part_Number 311-100KCRCT-ND
R61, R62: 59R; R_0805_2012Metric; Manufacturer_Part_Number RC0805FR-0759RL; DigiKey_Part_Number 311-59.0CRCT-ND
U1: MCP1802T-5002I/OT; MCP1802T-5002IOT; Manufacturer_Part_Number MCP1802T-5002I/OT; DigiKey_Part_Number MCP1802T-5002I/OTCT-ND
U4: LSF0204PWR; TSSOP-14_4.4x5mm_P0.65mm; Manufacturer_Part_Number LSF0204PWR; DigiKey_Part_Number 296-LSF0204PWRCT-ND
U8: ISOW1044; SOIC-20W_7.5x12.8mm_P1.27mm; Manufacturer_Part_Number ISOW1044BDFMR; DigiKey_Part_Number 296-ISOW1044BDFMRCT-ND

Connections:
3V3_Main: C31.1, C48.1, C49.1, C53.1, C54.1, R4.2, R10.2, R13.2, R14.2, R29.2, R51.2, R52.2, R55.2, R56.2, U4.1 (VREF_A), U8.1 (VIO), U8.9 (VDD); also elsewhere on the board
+5V: C1.1, C33.1, R1.2, R22.2, R31.2, R43.2, R49.2, U1.5 (VOUT), U4.14 (VREF_B)
+5VAiso: C46.1, C47.1, C50.1, FB3.2, U8.12 (VISOOUT)
+5Viso: C51.1, FB3.1, U8.13 (VSIN), U8.20 (VISOIN)
/Interfaces/CAN+: J17.1, R62.2, U8.19 (CANH)
/Interfaces/CAN-: J17.2, R61.1, U8.18 (CANL)
GND: C1.2, C4.2, C5.2, C23.2, C27.2, C31.2, C33.2, C37.2, C41.2, C48.2, C49.2, C53.2, C54.2, D1.1 (K), J2.2, J3.2, J4.2, J5.2, J6.3, J9.3, J10.3, J12.3, J13.2, J14.2, J15.2, J16.2, R32.1, U1.2 (VSS), U4.7 (GND), U8.4 (STB), U8.6 (GNDIO), U8.10 (GND1); also elsewhere on the board
GND_iso: C46.2, C47.2, C50.2, C51.2, C55.2, U8.11 (GND2), U8.15 (GISOIN), U8.16 (GISOIN), U8.17 (GISOIN)
ISO_CAN_RXD: U8.3 (TXD); also elsewhere on the board
ISO_CAN_TXD: U8.5 (RXD); also elsewhere on the board
unnamed: C23.1, J6.2, J20.1
unnamed: C55.1, R61.2, R62.1
unnamed: D1.2 (A), R1.1
unnamed: R29.1, R32.2, U4.8 (EN)
Servo1_Close: J15.1, R56.1; also elsewhere on the board
Servo1_Open: J16.1, R52.1; also elsewhere on the board
Servo1_PWM: U4.2 (A1); also elsewhere on the board
Servo1_Stepup: J12.1, R49.1, U4.13 (B1)
Servo2_Close: J14.1, R55.1; also elsewhere on the board
Servo2_Open: J13.1, R51.1; also elsewhere on the board
Servo2_PWM: U4.3 (A2); also elsewhere on the board
Servo2_Stepup: J10.1, R43.1, U4.12 (B2)
Servo3_Close: J5.1, R14.1; also elsewhere on the board
Servo3_Open: J4.1, R13.1; also elsewhere on the board
Servo3_PWM: U4.4 (A3); also elsewhere on the board
Servo3_Stepup: J9.1, R31.1, U4.11 (B3)
Servo4_Close: J3.1, R10.1; also elsewhere on the board
Servo4_Open: J2.1, R4.1; also elsewhere on the board
Servo4_PWM: U4.5 (A4); also elsewhere on the board
Servo4_Stepup: J6.1, R22.1, U4.10 (B4)
VIN_Filtered: C4.1, C5.1, C27.1, C37.1, C41.1, J9.2, J9.4 (Case), J10.2, J10.4 (Case), J12.2, J12.4 (Case), J20.2, U1.1 (VIN), U1.3 (*SHDN); also elsewhere on the board

Notes on the sheet:
Valves Control
CAN
STB -> GND : Normal mode EN/FLT floating : DC-DC enabled (internal pull-up)
*Max Vin <=10V *Max current delivered = 300mA
5V LDO for servo PWM control
3V3 to 5V logic level shifter for PWM control
Dump Valve Control
Standard servomotor header connector (maybe should think of something more secure)
Interfaces
Limit switch circuit. Connect on COM and NC or NO.
Enable when VREF_A is stable otherwise must be disable
