GAULAvionique/Cetautomatix/Hardware/PCB_Moteur/PCB_moteur.kicad_pcb

## KiCad design Hardware/PCB_Moteur/PCB_moteur.kicad_pcb (continued)

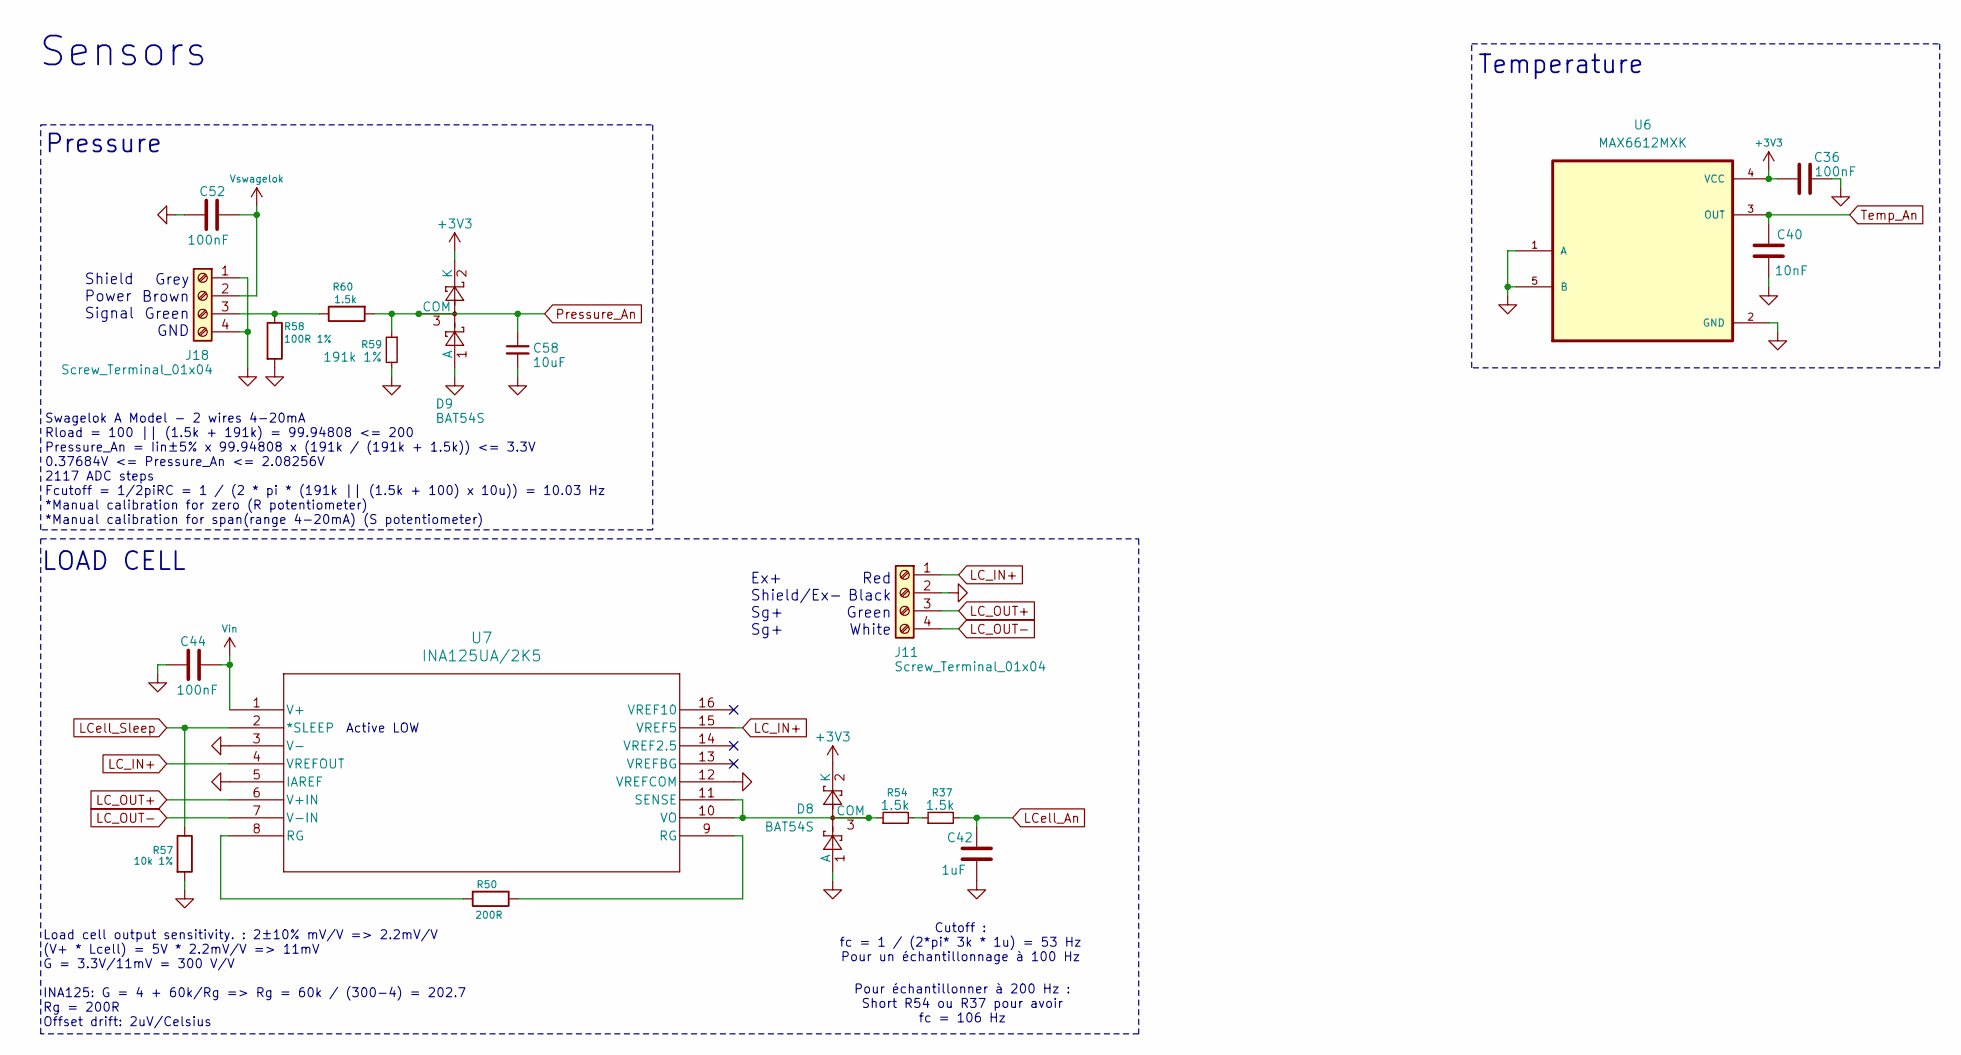
[picture p19: schematic Sensors.kicad_sch]

Parts:
C36, C44, C52: 100nF; C_0805_2012Metric; Manufacturer_Part_Number C0805C104K5RACTU; DigiKey_Part_Number 399-C0805C104K5RACTUCT-ND
C40: 10nF; C_0603_1608Metric; Manufacturer_Part_Number C0603C103K5RACTU; DigiKey_Part_Number 399-C0603C103K5RACTUCT-ND
C42: 1uF; C_0805_2012Metric; Manufacturer_Part_Number CL21B105KBFNNNE; DigiKey_Part_Number 1276-1029-1-ND
C58: 10uF; C_0805_2012Metric; Manufacturer_Part_Number CL21A106KAYNNNE; DigiKey_Part_Number 1276-2891-1-ND
D8, D9: BAT54S; SOT-23-3; Manufacturer_Part_Number BAT54S; DigiKey_Part_Number 4878-BAT54SCT-ND
J11, J18: Screw_Terminal_01x04; CONN_OSTVN04A150_OST; Manufacturer_Part_Number OSTVN04A150; DigiKey_Part_Number ED10563-ND
R37, R54, R60: 1.5k; R_0805_2012Metric; Manufacturer_Part_Number RC0805FR-071K5L; DigiKey_Part_Number 311-1.50KCRCT-ND
R50: 200R; R_0805_2012Metric; Manufacturer_Part_Number AC0805FR-07200RL; DigiKey_Part_Number YAG3707CT-ND
R57: 10k 1%; R_0805_2012Metric; Manufacturer_Part_Number CRCW080510K0FKEA; DigiKey_Part_Number 541-10.0KCCT-ND
R58: 100R 1%; R_0805_2012Metric; Manufacturer_Part_Number YAG3360CT-ND; DigiKey_Part_Number RT0805FRE07100RL
R59: 191k 1%; R_0805_2012Metric; Manufacturer_Part_Number RC0805FR-07191KL; DigiKey_Part_Number 311-191KCRCT-ND
U6: MAX6612MXK; SOT-353_SC-70-5; Manufacturer_Part_Number MAX6612MXK+T; DigiKey_Part_Number MAX6612MXK+TCT-ND
U7: INA125UA/2K5; D16-L; Manufacturer_Part_Number INA125UA/2K5; DigiKey_Part_Number 296-50343-1-ND

Connections:
3V3_Main: C36.1, D8.2 (K), D9.2 (K), U6.4 (VCC); also elsewhere on the board
GND: C36.2, C40.2, C42.2, C44.2, C52.1, C58.2, D8.1 (A), D9.1 (A), J11.2, J18.1, J18.4, R57.2, R58.2, R59.2, U6.1 (A), U6.2 (GND), U6.5 (B), U7.3 (V-), U7.5 (IAREF), U7.12 (VREFCOM); also elsewhere on the board
LC_IN+: J11.1, U7.4 (VREFOUT), U7.15 (VREF5)
LC_OUT+: J11.3, U7.6 (V+IN)
LC_OUT-: J11.4, U7.7 (V-IN)
LCell_An: C42.1, R37.2; also elsewhere on the board
LCell_Sleep: R57.1, U7.2 (*SLEEP); also elsewhere on the board
unnamed: D8.3 (COM), R54.1, U7.10 (VO), U7.11 (SENSE)
unnamed: J18.3, R58.1, R60.1
unnamed: R37.1, R54.2
unnamed: R50.1, U7.9 (RG)
unnamed: R50.2, U7.8 (RG)
Pressure_An: C58.1, D9.3 (COM), R59.1, R60.2; also elsewhere on the board
Temp_An: C40.1, U6.3 (OUT); also elsewhere on the board
VIN_Filtered: C44.1, U7.1 (V+); also elsewhere on the board
Vswagelok: C52.2, J18.2; also elsewhere on the board

Notes on the sheet:
Temperature
Cutoff : fc = 1 / (2*pi* 3k * 1u) = 53 Hz Pour un échantillonnage à 100 Hz
Active LOW
Load cell output sensitivity. : 2±10% mV/V => 2.2mV/V (V+ * Lcell) = 5V * 2.2mV/V => 11mV G = 3.3V/11mV = 300 V/V INA125: G = 4 + 60k/Rg => Rg = 60k / (300-4) = 202.7 Rg = 200R Offset drift: 2uV/Celsius
Red Black Green White
Ex+ Shield/Ex- Sg+ Sg+
Shield Power Signal
Grey Brown Green GND
LOAD CELL
Pour échantillonner à 200 Hz : Short R54 ou R37 pour avoir fc = 106 Hz
Sensors
Swagelok A Model - 2 wires 4-20mA Rload = 100 || (1.5k + 191k) = 99.94808 <= 200 Pressure_An = Iin±5% x 99.94808 x (191k / (191k + 1.5k)) <= 3.3V 0.37684V <= Pressure_An <= 2.08256V 2117 ADC steps Fcutoff = 1/2piRC = 1 / (2 * pi * (191k || (1.5k + 100) x 10u)) = 10.03 Hz *Manual calibration for zer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
Pressure

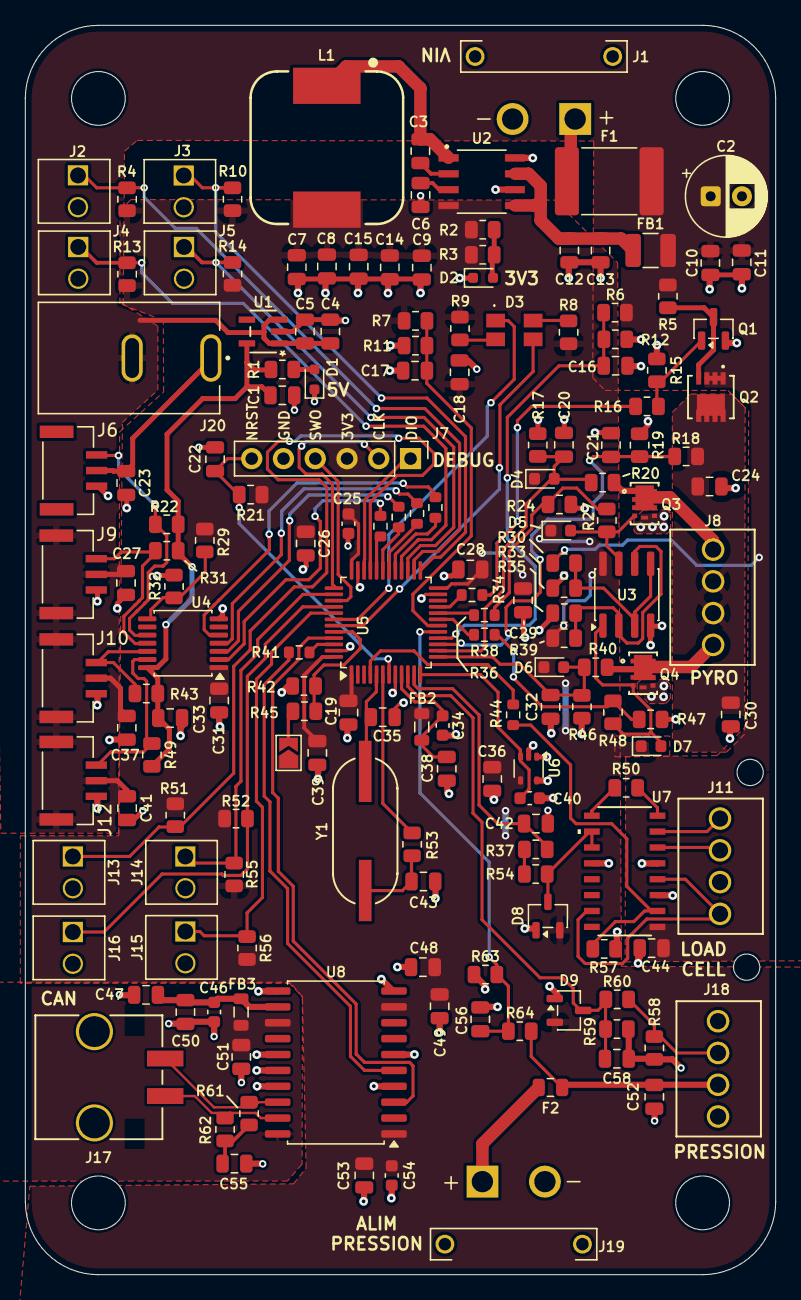
[picture p20: board PCB_moteur.kicad_pcb from above]

Board: 2 copper layers, 60.0 x 99.9 mm, 173 parts (0 on the bottom side), 92 nets.
