GAULAvionique/Cetautomatix/Hardware/PCB_GSE/PCB_GSE.kicad_pcb

## KiCad design Hardware/PCB_GSE/PCB_GSE.kicad_pcb (2026-03-09)

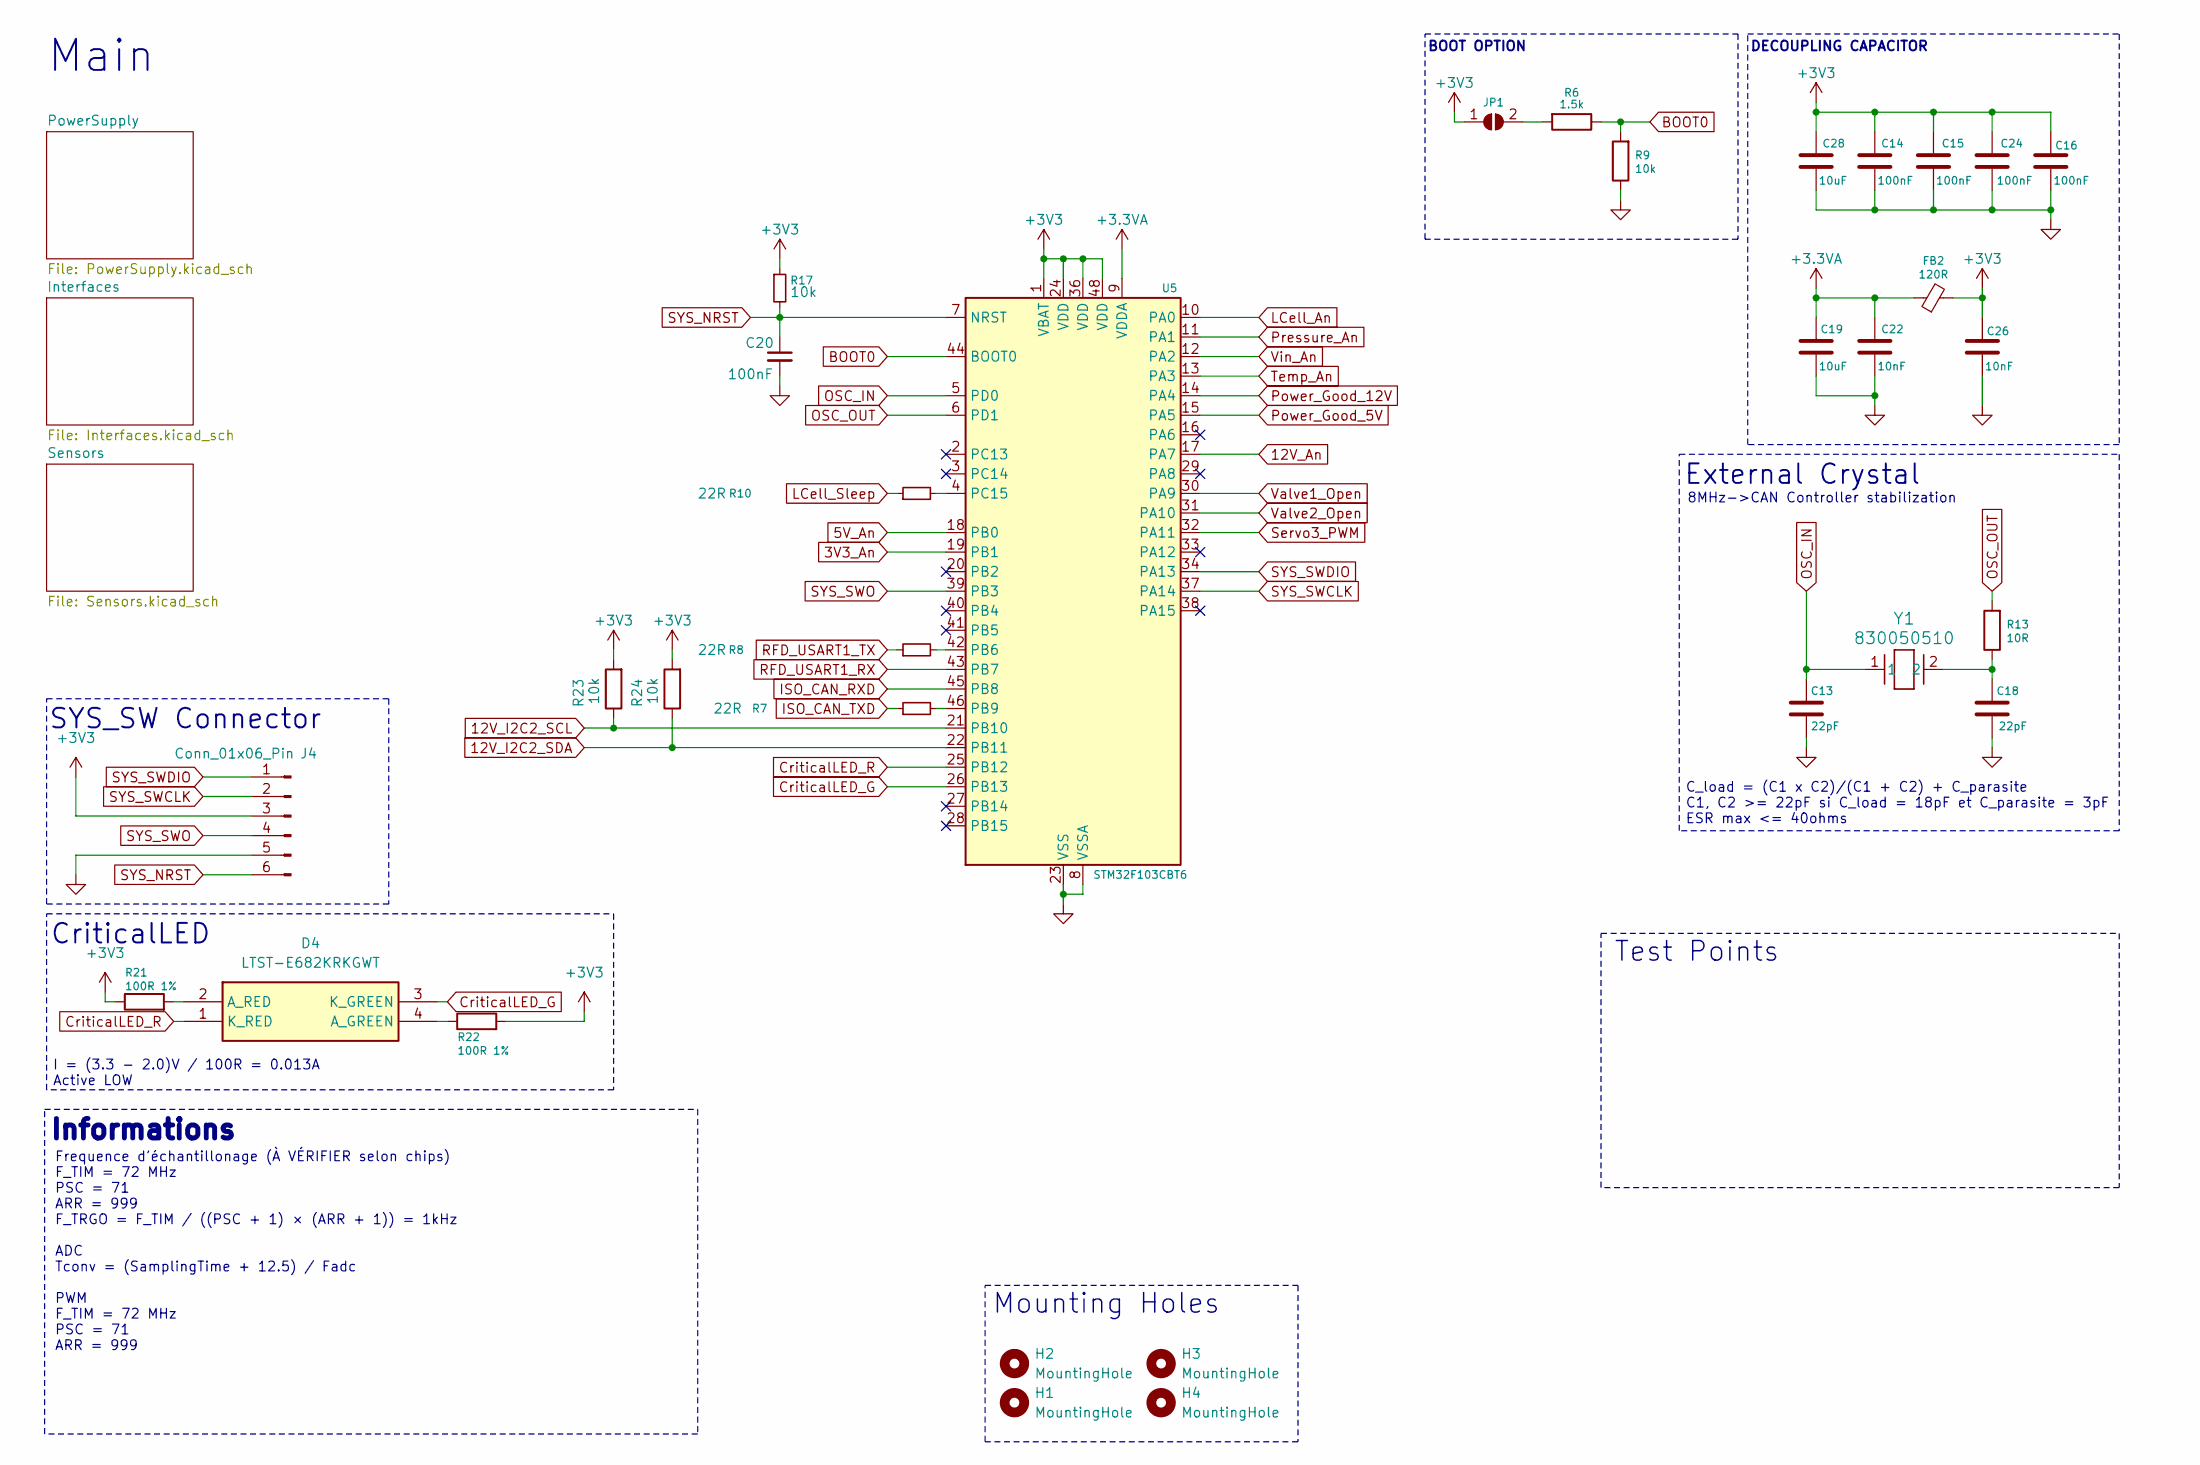
[picture p21: schematic PCB_GSE.kicad_sch]

Parts:
C13, C18: 22pF; C_0805_2012Metric; Manufacturer_Part_Number QSCT251Q220F1GV001E; DigiKey_Part_Number 712-QSCT251Q220F1GV001ECT-ND
C14, C15, C16, C20, C24: 100nF; C_0603_1608Metric; Manufacturer_Part_Number C0603C104K3RACTU; DigiKey_Part_Number 399-C0603C104K3RACTUCT-ND
C19, C28: 10uF; C_0805_2012Metric; Manufacturer_Part_Number CL21A106KAYNNNE; DigiKey_Part_Number 1276-2891-1-ND
C22, C26: 10nF; C_0805_2012Metric; Manufacturer_Part_Number CL21B103KAANNNC; DigiKey_Part_Number 1276-2434-1-ND
D4: LTST-E682KRKGWT; LTSTE683RGBW; Mouser Part Number 859-LTST-E682KRKGWT
FB2: 120R; L_0805_2012Metric; Manufacturer_Part_Number 2508051217Y6; DigiKey_Part_Number 1934-1472-1-ND
H1, H2, H3, H4: MountingHole; MountingHole_4.3mm_M4
J4: Conn_01x06_Pin; PinHeader_1x06_P2.54mm_Vertical; Manufacturer_Part_Number 61300611121; DigiKey_Part_Number 732-5319-ND
JP1: SolderJumper_2_Open; SolderJumper-2_P1.3mm_Open_TrianglePad1.0x1.5mm
R6: 1.5k; R_0805_2012Metric; Manufacturer_Part_Number RC0805FR-071K5L; DigiKey_Part_Number 311-1.50KCRCT-ND
R7, R8, R10: 22R; R_0603_1608Metric; Manufacturer_Part_Number ESR03EZPJ220; DigiKey_Part_Number RHM22DCT-ND
R9, R17, R23, R24: 10k; R_0805_2012Metric; Manufacturer_Part_Number CRCW080510K0FKEA; DigiKey_Part_Number 541-10.0KCCT-ND
R13: 10R; R_0805_2012Metric; Manufacturer_Part_Number RC0805FR-0710RL; DigiKey_Part_Number 311-10.0CRCT-ND
R21, R22: 100R 1%; R_0805_2012Metric; Manufacturer_Part_Number YAG3360CT-ND; DigiKey_Part_Number RT0805FRE07100RL
U5: STM32F103CBT6; LQFP-48_7x7mm_P0.5mm; Manufacturer_Part_Number STM32F103CBT6; DigiKey_Part_Number 497-6288-ND
Y1: 830050510; Manufacturer_Part_Number 830050510; DigiKey_Part_Number 1923-830050510CT-ND

Connections:
3V3_An: U5.19 (PB1); also elsewhere on the board
3V_Main: C14.2, C15.2, C16.2, C24.2, C26.2, C28.2, FB2.2, J4.3, JP1.1 (A), R17.1, R21.1, R22.2, R23.2, R24.2, U5.1 (VBAT), U5.24 (VDD), U5.36 (VDD), U5.48 (VDD); also elsewhere on the board
5V_An: U5.18 (PB0); also elsewhere on the board
12V_An: U5.17 (PA7); also elsewhere on the board
12V_I2C2_SCL: R23.1, U5.21 (PB10); also elsewhere on the board
12V_I2C2_SDA: R24.1, U5.22 (PB11); also elsewhere on the board
+3.3VA: C19.2, C22.2, FB2.1, U5.9 (VDDA)
BOOT0: R6.1, R9.2, U5.44 (BOOT0)
CriticalLED_G: D4.3 (K_GREEN), U5.26 (PB13)
CriticalLED_R: D4.1 (K_RED), U5.25 (PB12)
GND: C13.1, C14.1, C15.1, C16.1, C18.1, C19.1, C20.2, C22.1, C24.1, C26.1, C28.1, J4.5, R9.1, U5.8 (VSSA), U5.23 (VSS), U5.35 (VSS), U5.47 (VSS); also elsewhere on the board
ISO_CAN_RXD: U5.45 (PB8); also elsewhere on the board
ISO_CAN_TXD: R7.1; also elsewhere on the board
LCell_An: U5.10 (PA0); also elsewhere on the board
LCell_Sleep: R10.1; also elsewhere on the board
unnamed: C18.2, R13.1, Y1.2
unnamed: D4.4 (A_GREEN), R22.1
unnamed: D4.2 (A_RED), R21.2
unnamed: JP1.2 (B), R6.2
unnamed: R8.2, U5.42 (PB6)
unnamed: R7.2, U5.46 (PB9)
unnamed: R10.2, U5.4 (PC15)
OSC_IN: C13.2, U5.5 (PD0), Y1.1
OSC_OUT: R13.2, U5.6 (PD1)
Power_Good_5V: U5.15 (PA5); also elsewhere on the board
Power_Good_12V: U5.14 (PA4); also elsewhere on the board
Pressure_An: U5.11 (PA1); also elsewhere on the board
RFD_USART1_RX: U5.43 (PB7); also elsewhere on the board
RFD_USART1_TX: R8.1; also elsewhere on the board
SYS_NRST: C20.1, J4.6, R17.2, U5.7 (NRST)
SYS_SWCLK: J4.2, U5.37 (PA14)
SYS_SWDIO: J4.1, U5.34 (PA13)
SYS_SWO: J4.4, U5.39 (PB3)
Servo3_PWM: U5.32 (PA11); also elsewhere on the board
Temp_An: U5.13 (PA3); also elsewhere on the board
Valve1_Open: U5.30 (PA9); also elsewhere on the board
Valve2_Open: U5.31 (PA10); also elsewhere on the board
Vin_An: U5.12 (PA2); also elsewhere on the board

Notes on the sheet:
BOOT OPTION
SYS_SW Connector
I = (3.3 - 2.0)V / 100R = 0.013A Active LOW
CriticalLED
Test Points
External Crystal
Informations
C_load = (C1 x C2)/(C1 + C2) + C_parasite C1, C2 >= 22pF si C_load = 18pF et C_parasite = 3pF ESR max <= 40ohms
Main
8MHz->CAN Controller stabilization
DECOUPLING CAPACITOR
Frequence d'échantillonage (À VÉRIFIER selon chips) F_TIM = 72 MHz PSC = 71 ARR = 999 F_TRGO = F_TIM / ((PSC + 1) × (ARR + 1)) = 1kHz ADC Tconv = (SamplingTime + 12.5) / Fadc PWM F_TIM = 72 MHz PSC = 71 ARR = 999
Mounting Holes

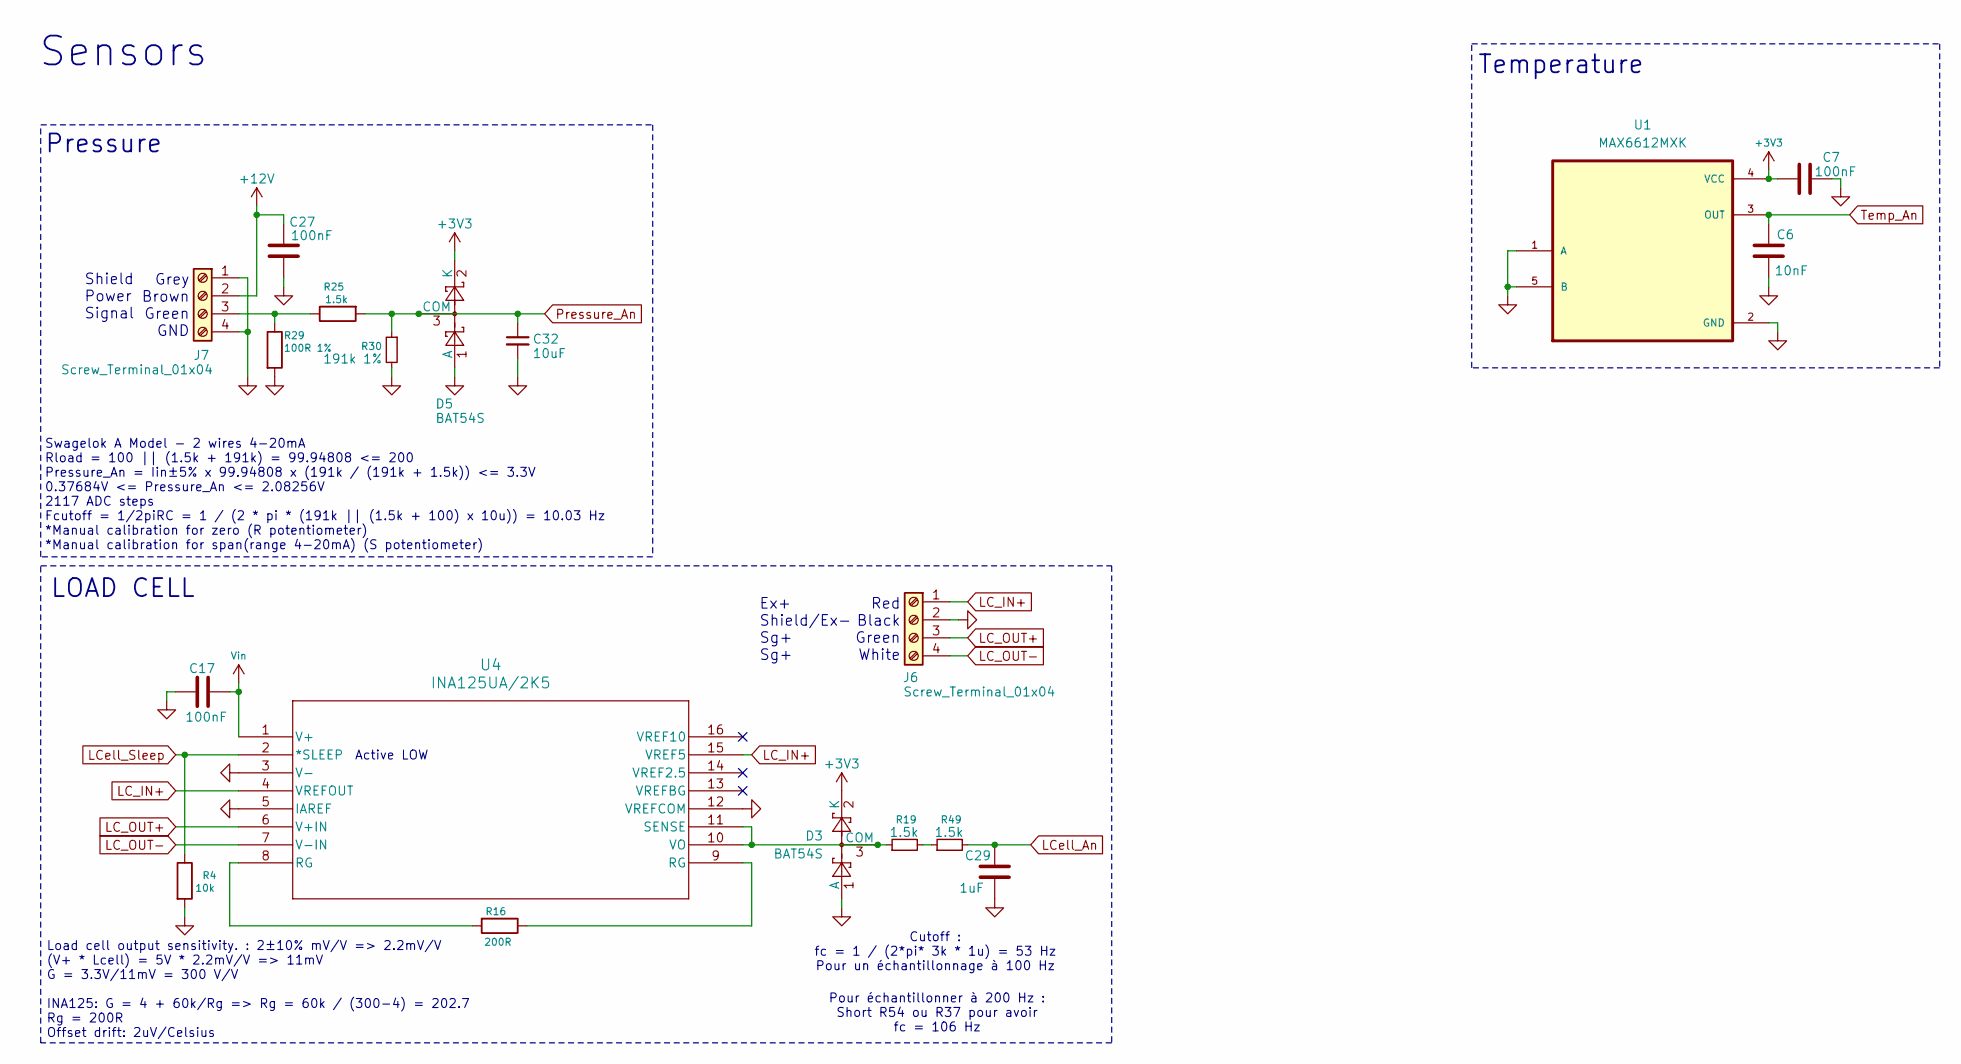
[picture p22: schematic Sensors.kicad_sch]

Parts:
C6: 10nF; C_0805_2012Metric; Manufacturer_Part_Number CL21B103KAANNNC; DigiKey_Part_Number 1276-2434-1-ND
C7, C17, C27: 100nF; C_0603_1608Metric; Manufacturer_Part_Number C0603C104K3RACTU; DigiKey_Part_Number 399-C0603C104K3RACTUCT-ND
C29: 1uF; C_0805_2012Metric; Manufacturer_Part_Number CL21B105KBFNNNE; DigiKey_Part_Number 1276-1029-1-ND
C32: 10uF; C_0805_2012Metric; Manufacturer_Part_Number CL21A106KAYNNNE; DigiKey_Part_Number 1276-2891-1-ND
D3, D5: BAT54S; SOT-23-3; Manufacturer_Part_Number BAT54S; DigiKey_Part_Number 4878-BAT54SCT-ND
J6, J7: Screw_Terminal_01x04; CONN_OSTVN04A150_OST; Manufacturer_Part_Number OSTVN04A150; DigiKey_Part_Number ED10563-ND
R4: 10k; R_0805_2012Metric; Manufacturer_Part_Number CRCW080510K0FKEA; DigiKey_Part_Number 541-10.0KCCT-ND
R16: 200R; R_0805_2012Metric; Manufacturer_Part_Number AC0805FR-07200RL; DigiKey_Part_Number YAG3707CT-ND
R19, R25, R49: 1.5k; R_0805_2012Metric; Manufacturer_Part_Number RC0805FR-071K5L; DigiKey_Part_Number 311-1.50KCRCT-ND
R29: 100R 1%; R_0805_2012Metric; Manufacturer_Part_Number YAG3360CT-ND; DigiKey_Part_Number RT0805FRE07100RL
R30: 191k 1%; R_0805_2012Metric; Manufacturer_Part_Number RC0805FR-07191KL; DigiKey_Part_Number 311-191KCRCT-ND
U1: MAX6612MXK; SOT-353_SC-70-5; Manufacturer_Part_Number MAX6612MXK+T; DigiKey_Part_Number MAX6612MXK+TCT-ND
U4: INA125UA/2K5; D16-L; Manufacturer_Part_Number INA125UA/2K5; DigiKey_Part_Number 296-50343-1-ND

Connections:
3V_Main: C7.1, D3.2 (K), D5.2 (K), U1.4 (VCC); also elsewhere on the board
GND: C6.2, C7.2, C17.2, C27.2, C29.2, C32.2, D3.1 (A), D5.1 (A), J6.2, J7.1, J7.4, R4.2, R29.2, R30.2, U1.1 (A), U1.2 (GND), U1.5 (B), U4.3 (V-), U4.5 (IAREF), U4.12 (VREFCOM); also elsewhere on the board
LC_IN+: J6.1, U4.4 (VREFOUT), U4.15 (VREF5)
LC_OUT+: J6.3, U4.6 (V+IN)
LC_OUT-: J6.4, U4.7 (V-IN)
LCell_An: C29.1, R49.2; also elsewhere on the board
LCell_Sleep: R4.1, U4.2 (*SLEEP); also elsewhere on the board
unnamed: D3.3 (COM), R19.1, U4.10 (VO), U4.11 (SENSE)
unnamed: J7.3, R25.1, R29.1
unnamed: R16.1, U4.9 (RG)
unnamed: R16.2, U4.8 (RG)
unnamed: R19.2, R49.1
Pressure_An: C32.1, D5.3 (COM), R25.2, R30.1; also elsewhere on the board
Temp_An: C6.1, U1.3 (OUT); also elsewhere on the board
VIN_Filtered: C17.1, U4.1 (V+); also elsewhere on the board
Vin_Valve: C27.1, J7.2; also elsewhere on the board

Notes on the sheet:
Load cell output sensitivity. : 2±10% mV/V => 2.2mV/V (V+ * Lcell) = 5V * 2.2mV/V => 11mV G = 3.3V/11mV = 300 V/V INA125: G = 4 + 60k/Rg => Rg = 60k / (300-4) = 202.7 Rg = 200R Offset drift: 2uV/Celsius
Temperature
LOAD CELL
Pressure
Pour échantillonner à 200 Hz : Short R54 ou R37 pour avoir fc = 106 Hz
Swagelok A Model - 2 wires 4-20mA Rload = 100 || (1.5k + 191k) = 99.94808 <= 200 Pressure_An = Iin±5% x 99.94808 x (191k / (191k + 1.5k)) <= 3.3V 0.37684V <= Pressure_An <= 2.08256V 2117 ADC steps Fcutoff = 1/2piRC = 1 / (2 * pi * (191k || (1.5k + 100) x 10u)) = 10.03 Hz *Manual calibration for zer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
Red Black Green White
Shield Power Signal
Sensors
Cutoff : fc = 1 / (2*pi* 3k * 1u) = 53 Hz Pour un échantillonnage à 100 Hz
Grey Brown Green GND
Ex+ Shield/Ex- Sg+ Sg+
Active LOW

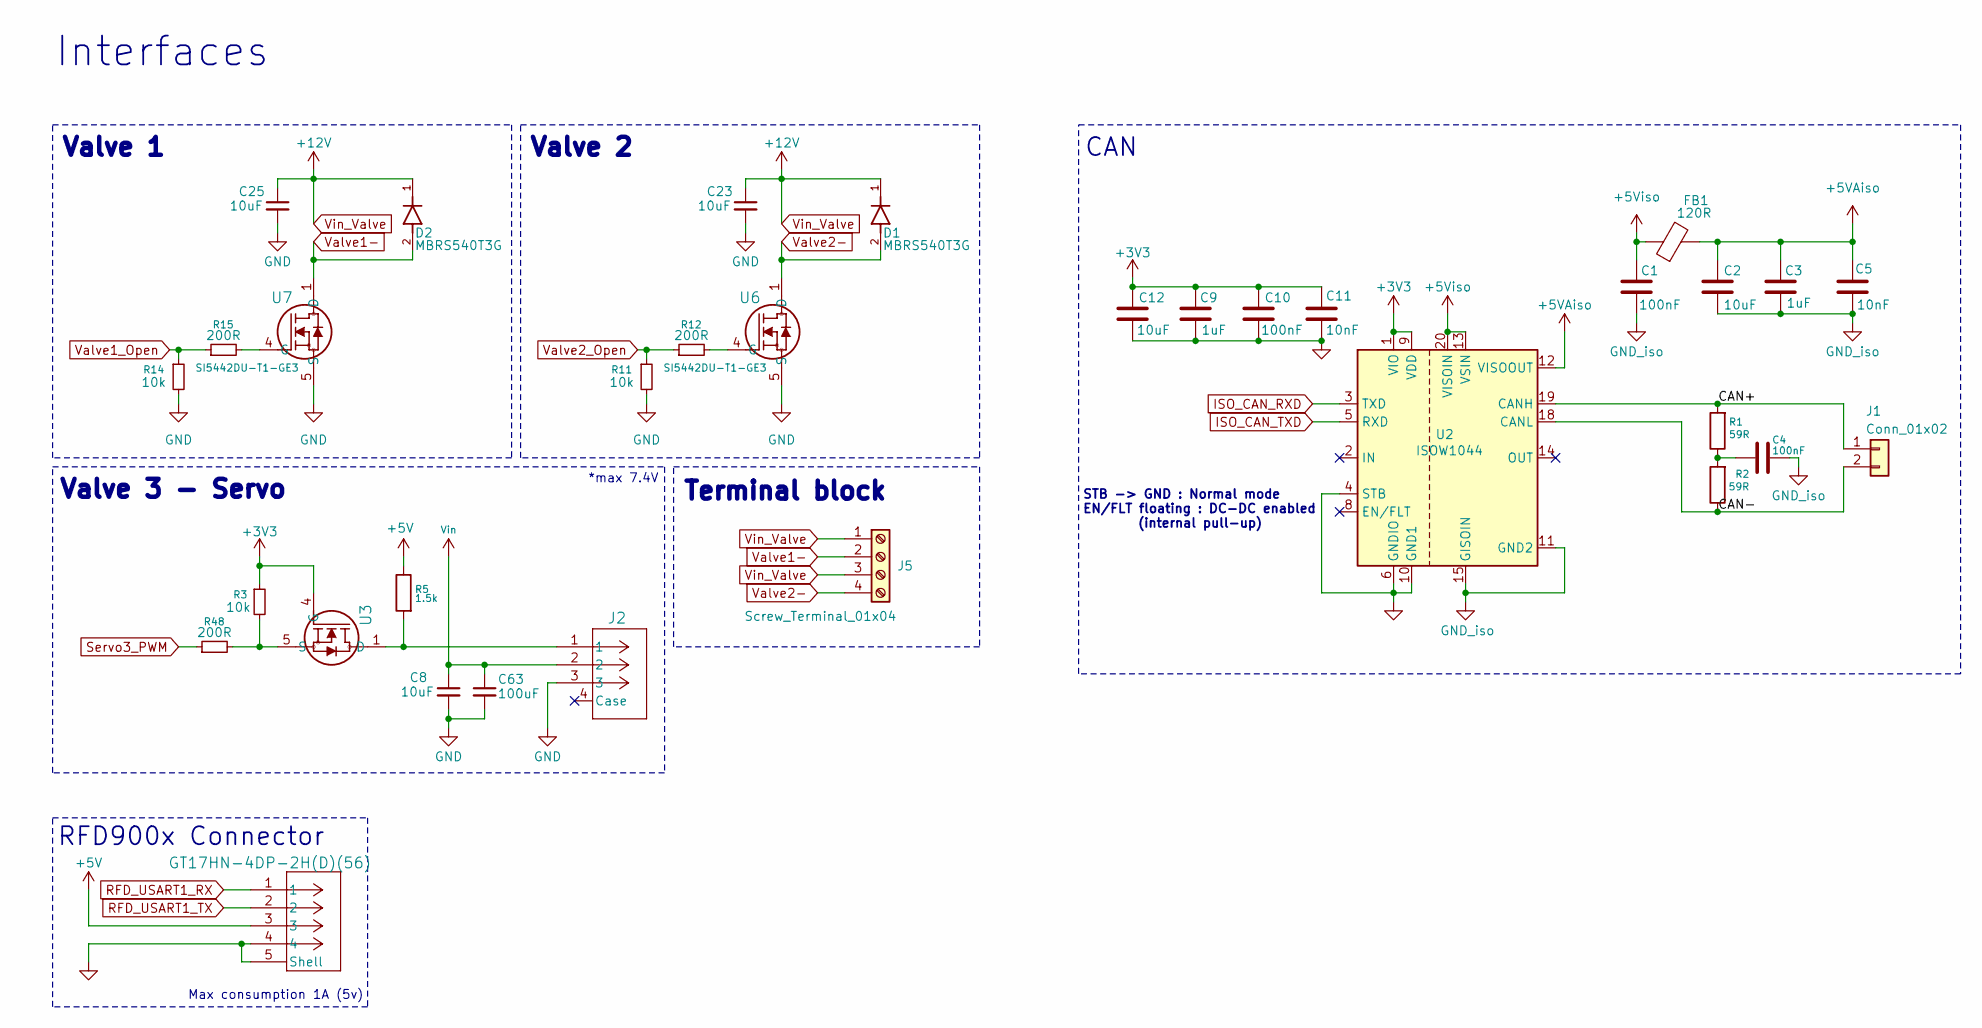
[picture p23: schematic Interfaces.kicad_sch]

Parts:
C1, C4, C10: 100nF; C_0603_1608Metric; Manufacturer_Part_Number C0603C104K3RACTU; DigiKey_Part_Number 399-C0603C104K3RACTUCT-ND
C2, C8, C12, C23, C25: 10uF; C_0805_2012Metric; Manufacturer_Part_Number CL21A106KAYNNNE; DigiKey_Part_Number 1276-2891-1-ND
C3, C9: 1uF; C_0805_2012Metric; Manufacturer_Part_Number CL21B105KBFNNNE; DigiKey_Part_Number 1276-1029-1-ND
C5, C11: 10nF; C_0805_2012Metric; Manufacturer_Part_Number CL21B103KAANNNC; DigiKey_Part_Number 1276-2434-1-ND
C63: 100uF; U2-K_NCH; Manufacturer_Part_Number UCL1E101MCL1GS; DigiKey_Part_Number 493-3937-1-ND
D1, D2: MBRS540T3G; DIODE_SMB_2L_ONS; PARTREV 7/27/2017; DigiKey_Part_Number MBRS130LT3GOSCT-ND
FB1: 120R; L_0805_2012Metric; Manufacturer_Part_Number 2508051217Y6; DigiKey_Part_Number 1934-1472-1-ND
J1: Conn_01x02; CONN_2189890010-SD_02_MOL; Manufacturer_Part_Number 2189890210; DigiKey_Part_Number 900-2189890210CT-ND
J2: SM03B-GHS-TB; JST_SM03B-GHS-TB; Manufacturer_Part_Number SM03B-GHS-TB; DigiKey_Part_Number 455-SM03B-GHS-TBCT-ND
J3: GT17HN-4DP-2H(D)(56); CONN4_GT17HN_HIR; Manufacturer_Part_Number GT17HN-4DP-2H(D)(56); DigiKey_Part_Number 26-GT17HN-4DP-2H(D)(56)-ND
J5: Screw_Terminal_01x04; CONN_OSTVN04A150_OST; Manufacturer_Part_Number OSTVN04A150; DigiKey_Part_Number ED10563-ND
R1, R2: 59R; R_0805_2012Metric; Manufacturer_Part_Number RC0805FR-0759RL; DigiKey_Part_Number 311-59.0CRCT-ND
R3, R11, R14: 10k; R_0805_2012Metric; Manufacturer_Part_Number CRCW080510K0FKEA; DigiKey_Part_Number 541-10.0KCCT-ND
R5: 1.5k; R_0805_2012Metric; Manufacturer_Part_Number RC0805FR-071K5L; DigiKey_Part_Number 311-1.50KCRCT-ND
R12, R15, R48: 200R; R_0805_2012Metric; Manufacturer_Part_Number AC0805FR-07200RL; DigiKey_Part_Number YAG3707CT-ND
U2: ISOW1044; SOIC-20W_7.5x12.8mm_P1.27mm; Manufacturer_Part_Number ISOW1044BDFMR; DigiKey_Part_Number 296-ISOW1044BDFMRCT-ND
U3, U6, U7: SI5442DU-T1-GE3; SI5442DU_T1_G3; Manufacturer_Part_Number SI5442DU-T1-GE3; DigiKey_Part_Number SI5442DU-T1-GE3CT-ND

Connections:
3V_Main: C9.1, C10.1, C11.1, C12.1, R3.1, U2.1 (VIO), U2.9 (VDD), U3.4 (G); also elsewhere on the board
5V_Main: J3.3, R5.1; also elsewhere on the board
+5VAiso: C2.1, C3.1, C5.1, FB1.2, U2.12 (VISOOUT)
+5Viso: C1.1, FB1.1, U2.13 (VSIN), U2.20 (VISOIN)
/Interfaces/CAN+: J1.1, R1.2, U2.19 (CANH)
/Interfaces/CAN-: J1.2, R2.1, U2.18 (CANL)
GND: C8.2, C9.2, C10.2, C11.2, C12.2, C23.2, C25.2, C63.2, J2.3, J3.4, J3.5 (Shell), R11.2, R14.2, U2.4 (STB), U2.6 (GNDIO), U2.10 (GND1), U6.5 (S), U6.9 (S), U7.5 (S), U7.9 (S); also elsewhere on the board
GND_iso: C1.2, C2.2, C3.2, C4.2, C5.2, U2.11 (GND2), U2.15 (GISOIN), U2.16 (GISOIN), U2.17 (GISOIN)
ISO_CAN_RXD: U2.3 (TXD); also elsewhere on the board
ISO_CAN_TXD: U2.5 (RXD); also elsewhere on the board
unnamed: C4.1, R1.1, R2.2
unnamed: J2.1, R5.2, U3.1 (D), U3.2 (D), U3.3 (D), U3.6 (D), U3.7 (D), U3.8 (D)
unnamed: R3.2, R48.2, U3.5 (S), U3.9 (S)
unnamed: R12.2, U6.4 (G)
unnamed: R15.2, U7.4 (G)
RFD_USART1_RX: J3.1; also elsewhere on the board
RFD_USART1_TX: J3.2; also elsewhere on the board
Servo3_PWM: R48.1; also elsewhere on the board
VIN_Filtered: C8.1, C63.1, J2.2; also elsewhere on the board
Valve1-: D2.2, J5.2, U7.1 (D), U7.2 (D), U7.3 (D), U7.6 (D), U7.7 (D), U7.8 (D)
Valve1_Open: R14.1, R15.1; also elsewhere on the board
Valve2-: D1.2, J5.4, U6.1 (D), U6.2 (D), U6.3 (D), U6.6 (D), U6.7 (D), U6.8 (D)
Valve2_Open: R11.1, R12.1; also elsewhere on the board
Vin_Valve: C23.1, C25.1, D1.1, D2.1, J5.1, J5.3; also elsewhere on the board

Notes on the sheet:
Max consumption 1A (5v)
Valve 3 - Servo
Interfaces
*max 7.4V
STB -> GND : Normal mode EN/FLT floating : DC-DC enabled (internal pull-up)
Valve 2
Valve 1
RFD900x Connector
Terminal block
CAN
