GAULAvionique/Cetautomatix/Hardware/PCB_GSE/PCB_GSE.kicad_pcb

## KiCad design Hardware/PCB_GSE/PCB_GSE.kicad_pcb (continued)

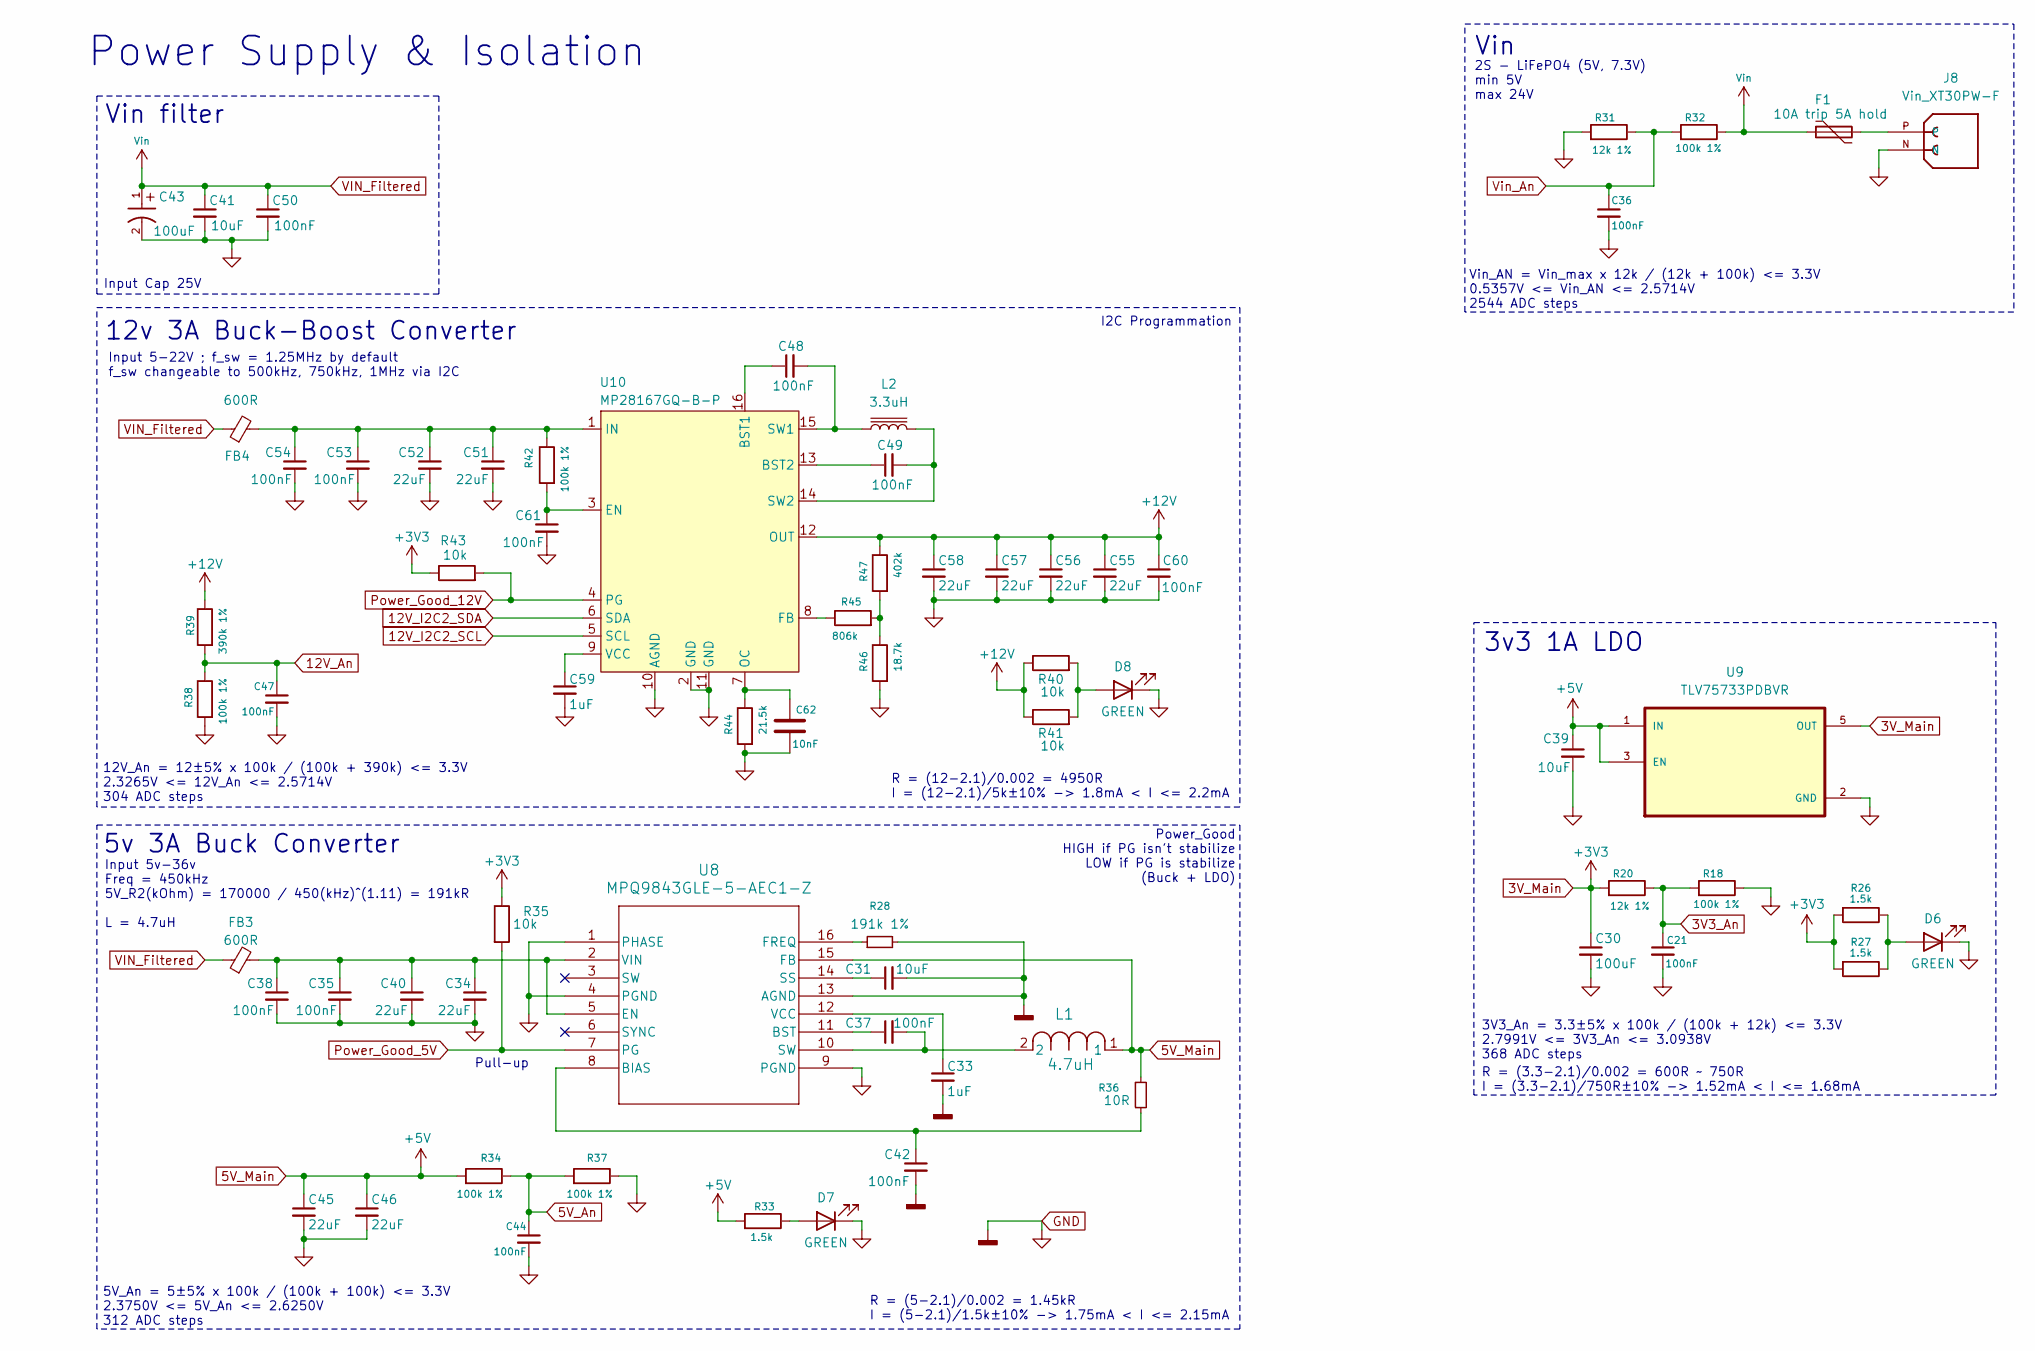
[picture p24: schematic PowerSupply.kicad_sch]

Parts:
C21, C35, C36, C37, C38, C42, C44, C47, C48, C49, C50, C53, C54, C60, C61: 100nF; C_0603_1608Metric; Manufacturer_Part_Number C0603C104K3RACTU; DigiKey_Part_Number 399-C0603C104K3RACTUCT-ND
C30: 100uF; C_1210_3225Metric; Manufacturer_Part_Number EMK325ABJ107MM-P; DigiKey_Part_Number 587-5426-1-ND
C31, C39, C41: 10uF; C_0805_2012Metric; Manufacturer_Part_Number CL21A106KAYNNNE; DigiKey_Part_Number 1276-2891-1-ND
C33, C59: 1uF; C_0805_2012Metric; Manufacturer_Part_Number CL21B105KBFNNNE; DigiKey_Part_Number 1276-1029-1-ND
C34, C40, C45, C46, C51, C52, C55, C56, C57, C58: 22uF; C_0805_2012Metric; Manufacturer_Part_Number C2012X5R1V226M125AC; DigiKey_Part_Number 445-14428-1-ND
C43: 100uF; U2-K_NCH; Manufacturer_Part_Number UCL1E101MCL1GS; DigiKey_Part_Number 493-3937-1-ND
C62: 10nF; C_0805_2012Metric; Manufacturer_Part_Number CL21B103KAANNNC; DigiKey_Part_Number 1276-2434-1-ND
D6, D7, D8: GREEN; LED_QBLP601-AG15; Manufacturer_Part_Number QBLP601-AG15; DigiKey_Part_Number 1516-QBLP601-AG15CT-ND
F1: 10A trip 5A hold; Fuse_2920_7451Metric; Manufacturer_Part_Number 2920L500/24SLDR; DigiKey_Part_Number 18-2920L500/24SLDRCT-ND
FB3, FB4: 600R; L_1210_3225Metric; Manufacturer_Part_Number FBMH3225HM601NT; DigiKey_Part_Number 587-1755-1-ND
J8: Vin_XT30PW-F; XT30PW-F; PARTREV 1.2
L1: 4.7uH; IND_PA4342_PUL; Manufacturer_Part_Number PA4342.472NLT; Digikey 553-3001-1-ND
L2: 3.3uH; MPL-AL6050-3R3; Manufacturer_Part_Number MPL-AL6050-3R3; DigiKey_Part_Number 1589-MPL-AL6050-3R3CT-ND
R18, R32, R34, R37, R38, R42: 100k 1%; R_0805_2012Metric; Manufacturer_Part_Number RC0805FR-07100KL; DigiKey_Part_Number 311-100KCRCT-ND
R20, R31: 12k 1%; R_0805_2012Metric; Manufacturer_Part_Number RC0805FR-0712KL; DigiKey_Part_Number 311-12.0KCRCT-ND
R26, R27, R33: 1.5k; R_0805_2012Metric; Manufacturer_Part_Number RC0805FR-071K5L; DigiKey_Part_Number 311-1.50KCRCT-ND
R28: 191k 1%; R_0805_2012Metric; Manufacturer_Part_Number RC0805FR-07191KL; DigiKey_Part_Number 311-191KCRCT-ND
R35, R40, R41, R43: 10k; R_0805_2012Metric; Manufacturer_Part_Number CRCW080510K0FKEA; DigiKey_Part_Number 541-10.0KCCT-ND
R36: 10R; R_0805_2012Metric; Manufacturer_Part_Number RC0805FR-0710RL; DigiKey_Part_Number 311-10.0CRCT-ND
R39: 390k 1%; R_0805_2012Metric; Manufacturer_Part_Number RK73H2ATTD3903F; DigiKey_Part_Number 2019-RK73H2ATTD3903FCT-ND
R44: 21.5k; R_0805_2012Metric; Manufacturer_Part_Number CRCW080521K5FKEA; DigiKey_Part_Number 541-21.5KCCT-ND
R45: 806k; R_0805_2012Metric; Manufacturer_Part_Number RC0805FR-07806KL; DigiKey_Part_Number 311-806KCRCT-ND
R46: 18.7k; R_0805_2012Metric; Manufacturer_Part_Number RMCF0805FT18K7; DigiKey_Part_Number RMCF0805FT18K7CT-ND
R47: 402k; R_0805_2012Metric; Manufacturer_Part_Number RC0805FR-07402KL; DigiKey_Part_Number 311-402KCRCT-ND
U8: MPQ9843GLE-5-AEC1-Z; MPQ9843GLE_5_AEC1_Z; Manufacturer_Part_Number MPQ9843GLE-5-AEC1-Z; DigiKey_Part_Number 1589-MPQ9843GLE-5-AEC1-ZCT-ND
U9: TLV75733PDBVR; SOT-23-5; Manufacturer_Part_Number TLV75733PDBVR; DigiKey_Part_Number 296-50414-1-ND
U10: MP28167GQ-B-P; QFN-16_MP28167_MNP; Manufacturer_Part_Number MP28167GQ-B-P; DigiKey_Part_Number 1589-MP28167GQ-B-PCT-ND

Connections:
3V3_An: C21.1, R18.2, R20.1; also elsewhere on the board
3V_Main: C30.1, R20.2, R26.2, R27.2, R35.1, R43.1, U9.5 (OUT); also elsewhere on the board
5V_An: C44.1, R34.1, R37.2; also elsewhere on the board
5V_Main: C39.1, C45.1, C46.1, L1.1, R33.2, R34.2, R36.1, U8.15 (FB), U9.1 (IN), U9.3 (EN); also elsewhere on the board
12V_An: C47.1, R38.1, R39.2; also elsewhere on the board
12V_I2C2_SCL: U10.5 (SCL); also elsewhere on the board
12V_I2C2_SDA: U10.6 (SDA); also elsewhere on the board
GND: C21.2, C30.2, C31.2, C33.2, C34.2, C35.2, C36.2, C38.2, C39.2, C40.2, C41.2, C42.2, C43.2, C44.2, C45.2, C46.2, C47.2, C50.2, C51.2, C52.2, C53.2, C54.2, C55.2, C56.2, C57.2, C58.2, C59.2, C60.2, C61.2, C62.1, D6.1 (K), D7.1 (K), D8.1 (K), J8.N, R18.1, R28.2, R31.2, R37.1, R38.2, R44.2, R46.2, U8.1 (PHASE), U8.4 (PGND), U8.9 (PGND), U8.13 (AGND), U9.2 (GND), U10.2 (GND), U10.10 (AGND), U10.11 (GND); also elsewhere on the board
unnamed: C37.2, L1.2, U8.10 (SW)
unnamed: D6.2 (A), R26.1, R27.1
unnamed: D7.2 (A), R33.1
unnamed: D8.2 (A), R40.2, R41.2
unnamed: F1.2, J8.P
unnamed: R45.2, R46.1, R47.2
unnamed: C42.1, R36.2, U8.8 (BIAS)
unnamed: C37.1, U8.11 (BST)
unnamed: C34.1, C35.1, C38.1, C40.1, FB3.2, U8.2 (VIN), U8.5 (EN)
unnamed: R28.1, U8.16 (FREQ)
unnamed: C31.1, U8.14 (SS)
unnamed: C33.1, U8.12 (VCC)
unnamed: C48.1, U10.16 (BST1)
unnamed: C49.1, U10.13 (BST2)
unnamed: C61.1, R42.2, U10.3 (EN)
unnamed: R45.1, U10.8 (FB)
unnamed: C51.1, C52.1, C53.1, C54.1, FB4.2, R42.1, U10.1 (IN)
unnamed: C62.2, R44.1, U10.7 (OC)
unnamed: C48.2, L2.1, U10.15 (SW1)
unnamed: C49.2, L2.2, U10.14 (SW2)
unnamed: C59.1, U10.9 (VCC)
Power_Good_5V: R35.2, U8.7 (PG); also elsewhere on the board
Power_Good_12V: R43.2, U10.4 (PG); also elsewhere on the board
VIN_Filtered: C41.1, C43.1, C50.1, F1.1, FB3.1, FB4.1, R32.1; also elsewhere on the board
Vin_An: C36.1, R31.1, R32.2; also elsewhere on the board
Vin_Valve: C55.1, C56.1, C57.1, C58.1, C60.1, R39.1, R40.1, R41.1, R47.1, U10.12 (OUT); also elsewhere on the board

Notes on the sheet:
I2C Programmation
R = (5-2.1)/0.002 = 1.45kR I = (5-2.1)/1.5k±10% -> 1.75mA < I <= 2.15mA
12v 3A Buck-Boost Converter
Vin
Input Cap 25V
Vin filter
Vin_AN = Vin_max x 12k / (12k + 100k) <= 3.3V 0.5357V <= Vin_AN <= 2.5714V 2544 ADC steps
Power Supply & Isolation
Pull-up
R = (3.3-2.1)/0.002 = 600R ~ 750R I = (3.3-2.1)/750R±10% -> 1.52mA < I <= 1.68mA
5v 3A Buck Converter
Input 5v-36v Freq = 450kHz 5V_R2(kOhm) = 170000 / 450(kHz)^(1.11) = 191kR L = 4.7uH
3v3 1A LDO
2S - LiFePO4 (5V, 7.3V) min 5V max 24V
5V_An = 5±5% x 100k / (100k + 100k) <= 3.3V 2.3750V <= 5V_An <= 2.6250V 312 ADC steps
R = (12-2.1)/0.002 = 4950R I = (12-2.1)/5k±10% -> 1.8mA < I <= 2.2mA
Input 5-22V ; f_sw = 1.25MHz by default f_sw changeable to 500kHz, 750kHz, 1MHz via I2C
12V_An = 12±5% x 100k / (100k + 390k) <= 3.3V 2.3265V <= 12V_An <= 2.5714V 304 ADC steps
3V3_An = 3.3±5% x 100k / (100k + 12k) <= 3.3V 2.7991V <= 3V3_An <= 3.0938V 368 ADC steps
Power_Good HIGH if PG isn't stabilize LOW if PG is stabilize (Buck + LDO)

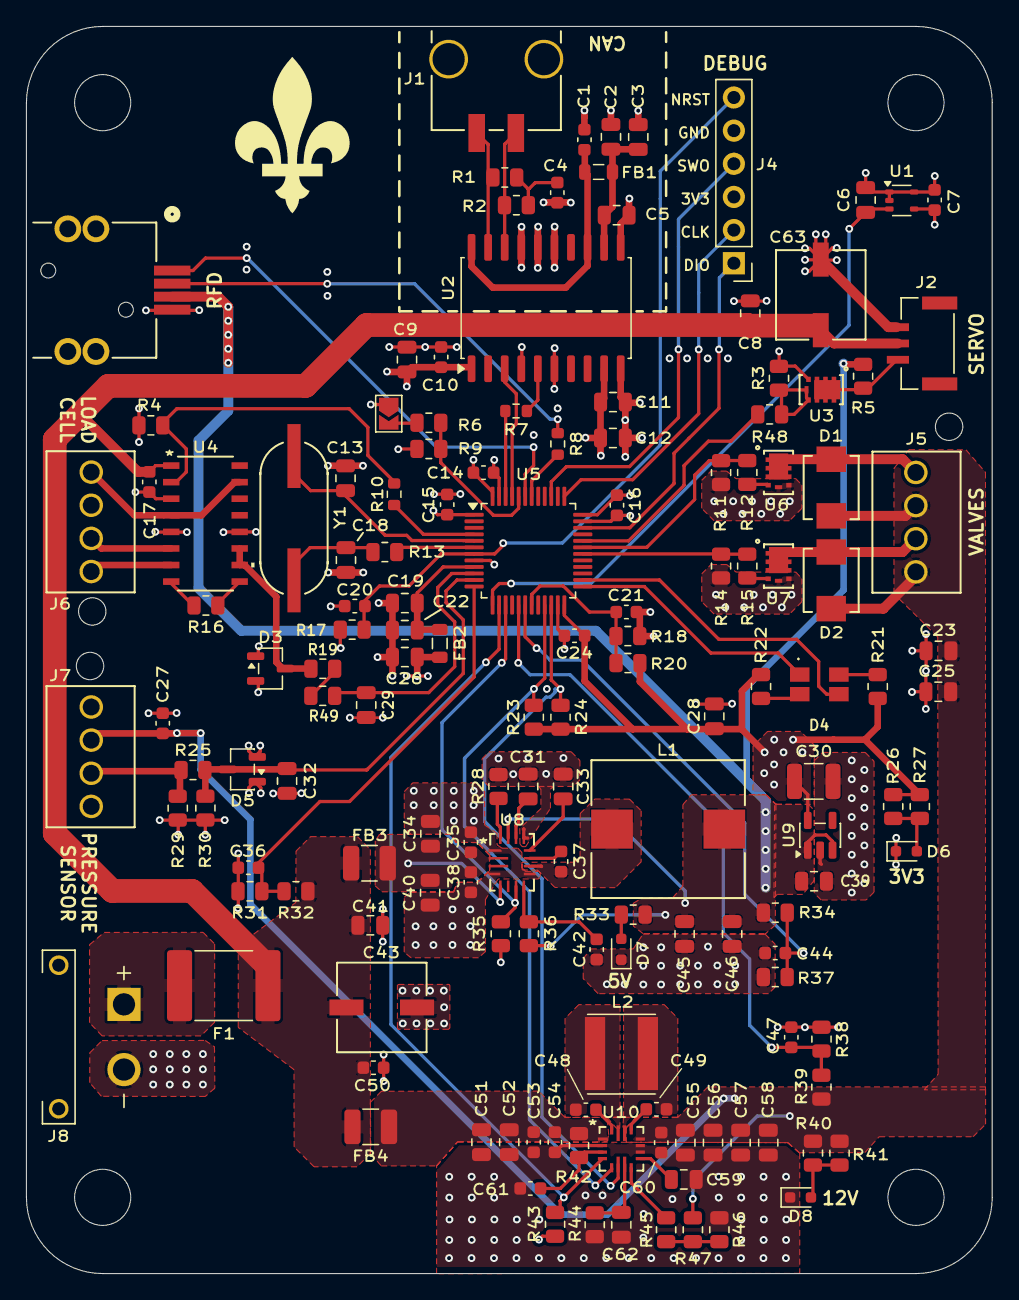
[picture p25: board PCB_GSE.kicad_pcb from above]

Board: 4 copper layers, 74.0 x 95.6 mm, 151 parts (0 on the bottom side), 82 nets.
