GAULAvionique/Cetautomatix/Software/STM32CubeIDE/trames/Core/Src/main.c

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
/* Includes ------------------------------------------------------------------*/
#include "main.h"
#include "can.h"
#include "usart.h"
#include "gpio.h"

/* USER CODE BEGIN Includes */
#include "protocol_defs.h"
#include "comm_utils.h"
#include "test_runner.h"
#include "comm_tx.h"
#include <string.h>
#include <stdbool.h>
#include <stdio.h>
/* USER CODE END Includes */

/* USER CODE BEGIN PD */
#define TEST_TIMEOUT_MS 100
/* USER CODE END PD */


void SystemClock_Config(void);
/**
  * @brief  The application entry point.
  * @retval int
  */
int main(void)
{

  /* MCU Configuration--------------------------------------------------------*/

  /* Reset of all peripherals, Initializes the Flash interface and the Systick. */
  HAL_Init();

  /* Configure the system clock */
  SystemClock_Config();

  /* Initialize all configured peripherals */
  MX_GPIO_Init();
  MX_CAN1_Init();
  MX_UART4_Init();
  /* USER CODE BEGIN 2 */

  /* ---- CAN Filter: accept all ---- */
  CAN_Filter_Config();

  if (HAL_CAN_Start(&hcan1) != HAL_OK) {
    Error_Handler();
  }

  /* ===== Fin tests ===== */

  /* USER CODE END 2 */

  /* Infinite loop */
  /* USER CODE BEGIN WHILE */
#ifdef UNIT_TEST
  run_all_tests();
  while (1) {
  }
#else
  /* ===== Tests UART4 & CAN1 ===== */
  const char *msg = "PROTO TEST: UART($..$) + CAN(DLC=1)\r\n";
  HAL_UART_Transmit(&huart4, (uint8_t*)msg, strlen(msg), 100);

  while (1)
  {
    /* USER CODE END WHILE */

    /* USER CODE BEGIN 3 */

    bool g_hb = false;
    run_end_to_end_test_once(&hcan1, &huart4, &g_hb, TEST_TIMEOUT_MS);
    HAL_Delay(1500);
  }
#endif
  /* USER CODE END 3 */
}

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
