GAULAvionique/Cetautomatix/Software/STM32CubeIDE/Moteur/CetautomatixMoteur.ioc

Mcu.UserName=STM32F103CBTx
PA0-WKUP.GPIO_Label=Pressure_An
PA0-WKUP.Signal=ADCx_IN0
PA1.GPIO_Label=LCell_An
PA1.Signal=ADCx_IN1
PA10.GPIO_Label=Servo2_PWM
PA10.Signal=S_TIM1_CH3
PA11.GPIO_Label=Servo1_PWM
PA11.Signal=S_TIM1_CH4
PA12.GPIO_Label=Servo2_Open
PA12.Signal=GPIO_Input
PA13.GPIO_Label=SYS_SWDIO
PA13.Signal=SYS_JTMS-SWDIO
PA14.GPIO_Label=SYS_SWCLK
PA14.Signal=SYS_JTCK-SWCLK
PA15.GPIO_Label=Servo2_Close
PA15.Signal=GPIO_Input
PA2.GPIO_Label=Temp_An
PA2.Signal=ADCx_IN2
PA3.GPIO_Label=Sense_1
PA3.Signal=ADCx_IN3
PA4.GPIO_Label=Sense_2
PA4.Signal=ADCx_IN4
PA5.GPIO_Label=PA_An
PA5.Signal=ADCx_IN5
PA6.GPIO_Label=Vin_An
PA6.Signal=ADCx_IN6
PA7.GPIO_Label=Vswagelok_An
PA7.Signal=ADCx_IN7
PA8.GPIO_Label=Servo4_PWM
PA8.Signal=S_TIM1_CH1
PA9.GPIO_Label=Servo3_PWM
PA9.Signal=S_TIM1_CH2
PB0.GPIO_Label=V3_An
PB0.Signal=ADCx_IN8
PB1.GPIO_Label=Fire_1
PB1.Signal=GPIO_Output
PB10.GPIO_Label=Pyros_Arm
PB10.Signal=GPIO_Output
PB12.GPIO_Label=Servo4_Close
PB12.Signal=GPIO_Input
PB13.GPIO_Label=Servo4_Open
PB13.Signal=GPIO_Input
PB14.GPIO_Label=Servo3_Close
PB14.Signal=GPIO_Input
PB15.GPIO_Label=Servo3_Open
PB15.Signal=GPIO_Input
PB2.GPIO_Label=Fire_2
PB2.Signal=GPIO_Output
PB3.GPIO_Label=SYS_SWO
PB3.Signal=SYS_JTDO-TRACESWO
PB4.GPIO_Label=Servo1_Open
PB4.Signal=GPIO_Input
PB5.GPIO_Label=Servo1_Close
PB5.Signal=GPIO_Input
PB6.GPIO_Label=CriticalLED_R
PB6.Signal=GPIO_Output
PB7.GPIO_Label=CriticalLED_G
PB7.Signal=GPIO_Output
PB8.GPIO_Label=ISO_CAN_RXD
PB8.Signal=CAN_RX
PB9.GPIO_Label=ISO_CAN_TXD
PB9.Signal=CAN_TX
PC15-OSC32_OUT.GPIO_Label=LCell_Sleep
PC15-OSC32_OUT.Signal=GPIO_Output
PD0-OSC_IN.GPIO_Label=OSC_IN
PD0-OSC_IN.Signal=RCC_OSC_IN
PD1-OSC_OUT.GPIO_Label=OSC_OUT
PD1-OSC_OUT.Signal=RCC_OSC_OUT
