GAULAvionique/Cetautomatix/Software/STM32CubeIDE/Moteur/Core/Inc/main.h

#define LCell_Sleep_Pin GPIO_PIN_15
#define LCell_Sleep_GPIO_Port GPIOC
#define OSC_IN_Pin GPIO_PIN_0
#define OSC_IN_GPIO_Port GPIOD
#define OSC_OUT_Pin GPIO_PIN_1
#define OSC_OUT_GPIO_Port GPIOD
#define Pressure_An_Pin GPIO_PIN_0
#define Pressure_An_GPIO_Port GPIOA
#define LCell_An_Pin GPIO_PIN_1
#define LCell_An_GPIO_Port GPIOA
#define Temp_An_Pin GPIO_PIN_2
#define Temp_An_GPIO_Port GPIOA
#define Sense_1_Pin GPIO_PIN_3
#define Sense_1_GPIO_Port GPIOA
#define Sense_2_Pin GPIO_PIN_4
#define Sense_2_GPIO_Port GPIOA
#define PA_An_Pin GPIO_PIN_5
#define PA_An_GPIO_Port GPIOA
#define Vin_An_Pin GPIO_PIN_6
#define Vin_An_GPIO_Port GPIOA
#define Vswagelok_An_Pin GPIO_PIN_7
#define Vswagelok_An_GPIO_Port GPIOA
#define V3_An_Pin GPIO_PIN_0
#define V3_An_GPIO_Port GPIOB
#define Fire_1_Pin GPIO_PIN_1
#define Fire_1_GPIO_Port GPIOB
#define Fire_2_Pin GPIO_PIN_2
#define Fire_2_GPIO_Port GPIOB
#define Pyros_Arm_Pin GPIO_PIN_10
#define Pyros_Arm_GPIO_Port GPIOB
#define Servo4_Close_Pin GPIO_PIN_12
#define Servo4_Close_GPIO_Port GPIOB
#define Servo4_Open_Pin GPIO_PIN_13
#define Servo4_Open_GPIO_Port GPIOB
#define Servo3_Close_Pin GPIO_PIN_14
#define Servo3_Close_GPIO_Port GPIOB
#define Servo3_Open_Pin GPIO_PIN_15
#define Servo3_Open_GPIO_Port GPIOB
#define Servo4_PWM_Pin GPIO_PIN_8
#define Servo4_PWM_GPIO_Port GPIOA
#define Servo3_PWM_Pin GPIO_PIN_9
#define Servo3_PWM_GPIO_Port GPIOA
#define Servo2_PWM_Pin GPIO_PIN_10
#define Servo2_PWM_GPIO_Port GPIOA
#define Servo1_PWM_Pin GPIO_PIN_11
#define Servo1_PWM_GPIO_Port GPIOA
#define Servo2_Open_Pin GPIO_PIN_12
#define Servo2_Open_GPIO_Port GPIOA
#define SYS_SWDIO_Pin GPIO_PIN_13
#define SYS_SWDIO_GPIO_Port GPIOA
#define SYS_SWCLK_Pin GPIO_PIN_14
#define SYS_SWCLK_GPIO_Port GPIOA
#define Servo2_Close_Pin GPIO_PIN_15
#define Servo2_Close_GPIO_Port GPIOA
#define SYS_SWO_Pin GPIO_PIN_3
#define SYS_SWO_GPIO_Port GPIOB
#define Servo1_Open_Pin GPIO_PIN_4
#define Servo1_Open_GPIO_Port GPIOB
#define Servo1_Close_Pin GPIO_PIN_5
#define Servo1_Close_GPIO_Port GPIOB
#define CriticalLED_R_Pin GPIO_PIN_6
#define CriticalLED_R_GPIO_Port GPIOB
#define CriticalLED_G_Pin GPIO_PIN_7
#define CriticalLED_G_GPIO_Port GPIOB
#define ISO_CAN_RXD_Pin GPIO_PIN_8
#define ISO_CAN_RXD_GPIO_Port GPIOB
#define ISO_CAN_TXD_Pin GPIO_PIN_9
#define ISO_CAN_TXD_GPIO_Port GPIOB
