GAULAvionique/Cetautomatix/Software/STM32CubeIDE/GSE/Core/Src/GAUL/Drivers/can_fifo.c

#include <GAUL/Drivers/can_fifo.h>


/*----------------------------
 CAN Init
----------------------------*/
int8_t CAN_FIFO_Init(can_t *dev, CAN_HandleTypeDef *hcan) {
	if(!dev || !hcan) return -1;

    dev->hcan = hcan;

    if(RingBuffer_Init(&dev->rx_rb, dev->rx_buffer_storage, CAN_RX_BUFFER_SIZE, sizeof(can_frame_t)) != 0) return -1;

    if(HAL_CAN_Start(dev->hcan) != HAL_OK) return -1;

    HAL_CAN_ActivateNotification(dev->hcan,
        CAN_IT_RX_FIFO0_MSG_PENDING |
        CAN_IT_RX_FIFO1_MSG_PENDING |
        CAN_IT_BUSOFF |
        CAN_IT_ERROR_WARNING |
        CAN_IT_ERROR_PASSIVE |
        CAN_IT_ERROR
    );

    CAN_FIFO_SetTXHeader(dev, CAN_ID_NORMAL, 1);

    return 0;
}

/*----------------------------
 CAN TX with package priority
----------------------------*/
int8_t CAN_FIFO_Send(can_t *dev, const uint8_t *package) {
    if(!dev || !package) return -1;

    if(HAL_CAN_GetTxMailboxesFreeLevel(dev->hcan) == 0) return -1;

    uint32_t txMailbox;
    if(HAL_CAN_AddTxMessage(dev->hcan, &dev->tx_header, (uint8_t *)package, &txMailbox) != HAL_OK)
        return -1;

    return 0;
}

void CAN_FIFO_SetTXHeader(can_t *dev, uint32_t id, uint8_t len) {
    if(!dev || len == 0) return;

    dev->tx_header.StdId = (id & 0x7FFu);
    dev->tx_header.ExtId = 0;
    dev->tx_header.IDE = CAN_ID_STD;
    dev->tx_header.RTR = CAN_RTR_DATA;
    dev->tx_header.DLC = len;
    dev->tx_header.TransmitGlobalTime = DISABLE;
}

/*----------------------------
 CAN RX with interrupts
----------------------------*/
bool CAN_FIFO_ReadFrame(can_t *dev, can_frame_t *frame) {
	if(CAN_FIFO_Available(dev) == 0) return false;

	return (RingBuffer_Read(&dev->rx_rb, frame, 1) == 1);
}

uint16_t CAN_FIFO_Available(can_t *dev) {
    return RingBuffer_Available(&dev->rx_rb);
}

/*----------------------------
 CAN RX0 Interrupt
----------------------------*/
void CAN_FIFO_RX0_IRQHandler_Callback(can_t *dev) {
    CAN_RxHeaderTypeDef rx_header;
    can_frame_t frame;

    while(HAL_CAN_GetRxMessage(dev->hcan, CAN_RX_FIFO0, &rx_header, frame.data) == HAL_OK) {
        frame.id  = rx_header.StdId;
        frame.dlc = rx_header.DLC;
        RingBuffer_Write(&dev->rx_rb, &frame, 1);
    }
}

/*----------------------------
 CAN RX1 Interrupt
----------------------------*/
void CAN_FIFO_RX1_IRQHandler_Callback(can_t *dev) {
    CAN_RxHeaderTypeDef rx_header;
    can_frame_t frame;

    while(HAL_CAN_GetRxMessage(dev->hcan, CAN_RX_FIFO1, &rx_header, frame.data) == HAL_OK) {
		frame.id  = rx_header.StdId;
		frame.dlc = rx_header.DLC;
		RingBuffer_Write(&dev->rx_rb, &frame, 1);
	}
}

/*----------------------------
 CAN SCE Interrupt
----------------------------*/
void CAN_FIFO_SCE_IRQHandler_Callback(can_t *dev) {
    uint32_t error = HAL_CAN_GetError(dev->hcan);

    if(error & HAL_CAN_ERROR_BOF) {
        HAL_CAN_ResetError(dev->hcan);
        HAL_CAN_Start(dev->hcan);
    }

    if(error & HAL_CAN_ERROR_EPV) {
    	// ...
    }

    if(error & HAL_CAN_ERROR_EWG) {
    	// ...
    }
}
