GAULAvionique/Cetautomatix/(commit log)

2025-10-25 création projets kicad
    [PCB_GSE.kicad_pcb, PCB_GSE.kicad_sch, PCB_moteur.kicad_pcb, PCB_moteur.kicad_sch]
2025-11-06 Début schéma moteurs
    [Interface.kicad_sch, Interfaces_moteur.kicad_sch, PCB_GSE.kicad_sch, PCB_moteur.kicad_sch, STM32_moteur.kicad_sch, Supply_moteur.kicad_sch, supply.kicad_sch, untitled.kicad_sch]
2025-11-09 fix: repo
    [PCB_GSE.kicad_pcb, PCB_GSE.kicad_sch, PCB_moteur.kicad_pcb, PCB_moteur.kicad_sch]
2025-11-10 tx de rfd et can, pas encore tester, donc d'autres modifications à venir
2025-11-10 Revert "tx de rfd et can, pas encore tester, donc d'autres modifications à venir"
    This reverts commit 7740cc68a9cf953570aa067b4b73ca5d330767ca.
2025-12-27 Manque supply, pyro et finition (découplage etc)
    [Interfaces_moteur.kicad_sch, PCB_moteur.kicad_sch, Pyros.kicad_sch, STM32_moteur.kicad_sch, Supply_moteur.kicad_sch]
2025-12-27 wip: remove unnecessary components
    [Interfaces_moteur.kicad_sch, PCB_moteur.kicad_sch, STM32_moteur.kicad_sch, Supply_moteur.kicad_sch]
2025-12-27 wip: change 4 pyros -> 2 pyros
    [Interfaces_moteur.kicad_sch, Pyros.kicad_sch, STM32_moteur.kicad_sch]
2026-01-11 trames de commande
2026-01-12 fix: power supply + add LED RG + add mounting holes + change 6pins header SWD connector + pyros
    [Interfaces_moteur.kicad_sch, LTST-E682KRKGWT.stp, Pyros.kicad_sch, STM32_moteur.kicad_sch, Supply_moteur.kicad_sch]
2026-01-13 fix: resistors + capacitances power supply
    [Interfaces_moteur.kicad_sch, Pyros.kicad_sch, STM32_moteur.kicad_sch, Supply_moteur.kicad_sch]
2026-01-14 Added LDO, INA125, sensors
    [Interfaces_moteur.kicad_sch, PCB_moteur.kicad_sch, Pyros.kicad_sch, STM32_moteur.kicad_sch, Sensors.kicad_sch, Supply_moteur.kicad_sch]
2026-01-14 finis pression, loadcell, temperature
    [Sensors.kicad_sch]
2026-01-15 fichier des composants
    téléchargement des fichiers des divers composant
2026-01-15 ajout des composant (vérification des pin à faire !!!!!!!!!!!!!!!!!)
2026-01-15 modification des symbole
2026-01-15 un espace de retiré
2026-01-15 modif mineure (pull-up, découplage)
    [Interfaces_moteur.kicad_sch]
2026-01-16 fix: pyros resistors + typos +
    [Interfaces_moteur.kicad_sch, Pyros.kicad_sch, Sensors.kicad_sch]
2026-01-17 fix: resistance ratios + typos
    [Interfaces_moteur.kicad_sch, Pyros.kicad_sch, Sensors.kicad_sch, Supply_moteur.kicad_sch]
2026-01-17 repo: change directories + rename branches
    [Interface.kicad_sch, Interfaces_moteur.kicad_sch, LTST-E682KRKGWT.stp, PCB_GSE.kicad_pcb, PCB_GSE.kicad_sch, PCB_moteur.kicad_pcb, PCB_moteur.kicad_sch, Pyros.kicad_sch]
2026-01-17 feat: add stm32 project
2026-01-17 feat: setup stm32 project + mapping + add led LDO
    [Interfaces_moteur.kicad_sch, STM32_moteur.kicad_sch, Sensors.kicad_sch]
2026-01-17 fix: minor corrections aux servos avant souper
2026-01-18 fix: LDO SHDN + complete stm32cubeide mapping (kicad missing) + add CAN in binary signal (connector missing)
    [Interfaces_moteur.kicad_sch, Sensors.kicad_sch, Supply_moteur.kicad_sch]
2026-01-18 rapport générer pour les connecteurs du stm32
2026-01-18 fix: readd mapping changes (save)
    [main.c, main.h]
2026-01-18 wip : pin mapping on STM32 and limit switch circuit
    [Interfaces_moteur.kicad_sch, STM32_moteur.kicad_sch, Sensors.kicad_sch, Supply_moteur.kicad_sch]
2026-01-18 feat: add extend ios + fix mapping kicad + add transmitter resistors
    [Interfaces_moteur.kicad_sch, STM32_moteur.kicad_sch]
2026-01-18 fix: LDO 5V SHDN + REFs (missing) + change EN valves controller connection + fix intrumental ampliop + add pull-down to sleep pins
    [Interfaces_moteur.kicad_sch, Pyros.kicad_sch, STM32_moteur.kicad_sch, Sensors.kicad_sch, Supply_moteur.kicad_sch]
2026-01-19 Calculs gains, filtre rc
    [Sensors.kicad_sch, Supply_moteur.kicad_sch]
2026-01-19 wip : minor corrections and fix footprints except connectors
    [Interfaces_moteur.kicad_sch, Pyros.kicad_sch, STM32_moteur.kicad_sch, Sensors.kicad_sch, Supply_moteur.kicad_sch]
2026-01-19 fix: symbols refactorisation (footprint missing)
    [150080GS75000.step, 875115652007.stp, INA125UA_2K5.stp, INA333AIDGKR.stp, ISOW1044BDFMR.stp, Interfaces_moteur.kicad_sch, L6981N33DR.step, LSF0204PWR.stp]
2026-01-19 restoration des descriptions et des informations/link
2026-01-19 wip : done all footprints
    [2189890210.stp, 640454-2.step, Interfaces_moteur.kicad_sch, Pyros.kicad_sch, STM32_moteur.kicad_sch, Sensors.kicad_sch, Supply_moteur.kicad_sch]
2026-01-19 wip : add final footprint to lib and start pcb
    [Interfaces_moteur.kicad_sch, PCB_moteur.kicad_pcb, Sensors.kicad_sch]
2026-01-19 changement de fichier de symbole pour un avec plus de modèle et ajout du deuxième fichier au cas où il le symbole à été mis dedans.
2026-01-19 tout les footprint son prêt
    [Sensors.kicad_sch]
2026-01-19 board size et exploration
    [PCB_moteur.kicad_pcb]
2026-01-20 début alim
    [PCB_moteur.kicad_pcb, Supply_moteur.kicad_sch]
2026-01-20 Version avec vraiment les compo 3d
    [PCB_moteur.kicad_pcb]
2026-01-20 Layout Alim 3.3V + pression et loadcell
    [PCB_moteur.kicad_pcb, Sensors.kicad_sch]
2026-01-20 un peux de regroupement sans faire exactement le layout
    [PCB_moteur.kicad_pcb]
2026-01-20 wip: layout circuits Pyro
    [Interfaces_moteur.kicad_sch, PCB_moteur.kicad_pcb, Pyros.kicad_sch, STM32_moteur.kicad_sch, Sensors.kicad_sch, Supply_moteur.kicad_sch]
2026-01-20 wip: début CAN Layout
    [PCB_moteur.kicad_pcb]
2026-01-21 wip: fin layout CAN et interface servo
    [PCB_moteur.kicad_pcb, STM32_moteur.kicad_sch]
2026-01-21 fix(stm32): update pin servo1 <-> servo2
    [main.c, main.h]
2026-01-21 wip: fin des circuits sauf ceux du STM
    [Interfaces_moteur.kicad_sch, Supply_moteur.kicad_sch]
2026-01-21 wip: layout presque fini (decoup stm32 restant)
    [Interfaces_moteur.kicad_sch, PCB_moteur.kicad_pcb, STM32_moteur.kicad_sch, Sensors.kicad_sch]
2026-01-21 wip: nouveaux connecteurs et espace pour ceux-ci
    [BM03B-GHS-TBT.STEP, Interfaces_moteur.kicad_sch, PCB_moteur.kicad_pcb]
2026-01-22 wip: arrangement connecteurs et modeles 3D
    [BM03B-GHS-TBT.STEP, Download_WE-PD_1245_STP_rev1.stp, Interfaces_moteur.kicad_sch, PCB_moteur.kicad_pcb, Supply_moteur.kicad_sch]
2026-01-22 wip: finis layout, DRIP MAXIMALE
    [PCB_moteur.kicad_pcb]
2026-01-22 ajout des composants dans GSE
    [2189890210.stp, 640454-2.step, BM03B-GHS-TBT.STEP, Download_WE-PD_1245_STP_rev1.stp, PCB_moteur.kicad_pcb.hierpcb.json]
2026-01-22 wip: début routing
    [PCB_moteur.kicad_pcb, Sensors.kicad_sch]
2026-01-22 hierarchisation des feuille
    [Alimentation.kicad_sch, Amp_int.kicad_sch, Buck3V3.kicad_sch, Buck5V.kicad_sch, Camp3V3.kicad_sch, Capteurs.kicad_sch, Comp_user.kicad_sch, Extension.kicad_sch]
2026-01-23 un peux d'avancement (brouillon)
    [Alimentation.kicad_sch, Amp_int.kicad_sch, Buck3V3.kicad_sch, Buck5V.kicad_sch, Camp3V3.kicad_sch, Capteurs.kicad_sch, Comp_user.kicad_sch, Interface.kicad_sch]
2026-01-23 wip: routing (suite)
    [Interfaces_moteur.kicad_sch, PCB_moteur.kicad_pcb]
2026-01-23 feat: copy all existing schematics in gse project + add missing components + fix voltage divider for 3S + create gse project and seperate stm32 project + add missing resistors motor
    [Alimentation.kicad_sch, Amp_int.kicad_sch, Buck3V3.kicad_sch, Buck5V.kicad_sch, Camp3V3.kicad_sch, Capteurs.kicad_sch, Comp_user.kicad_sch, Extension.kicad_sch]
2026-01-24 wip: routing sys et limit switches
    [PCB_moteur.kicad_pcb, STM32_moteur.kicad_sch]
2026-01-24 fix: typos
    [Interfaces.kicad_sch]
2026-01-25 feat: add 12V buck converter + inductance symbol/footprint
    [LM2673SX-12_NOPB.step, PowerSupply.kicad_sch, WE-PD_1245.step]
2026-01-26 feat: finish 12V-3A buck converter
    [PowerSupply.kicad_sch]
2026-01-26 fix: add ferritbead + remove typos
    [PowerSupply.kicad_sch]
2026-01-26 fix: stm32 project + modified 12v buck symbol
    [PCB_GSE.kicad_sch, PowerSupply.kicad_sch]
2026-01-26 fix: change Schottky diode 12v buck
    [Interfaces.kicad_sch, MBRS540T3G.step, PowerSupply.kicad_sch]
2026-01-26 feat: add valve control + needed components
    [Interfaces.kicad_sch]
2026-01-26 feat: add extended ios + add stm32 project extended ios +
    [Interfaces.kicad_sch, PCB_GSE.kicad_sch]
2026-01-27 feat: change buck 3v3 1A ->5V 3A to 3.3V 1A cascade LDO + add symbol/footprint
    [PowerSupply.kicad_sch, TLV75733PDBVR.step]
2026-01-29 wip: finit routing servo et limit switch, début pyro
    [Pyros.kicad_sch]
2026-01-29 wip: pyro suite
    [PCB_moteur.kicad_pcb, Pyros.kicad_sch]
2026-01-30 wip: routing, bientot plane d'alim!
    [PCB_moteur.kicad_pcb, Pyros.kicad_sch, STM32_moteur.kicad_sch]
2026-01-30 wip: reste plane
    [PCB_moteur.kicad_pcb, STM32_moteur.kicad_sch]
2026-02-01 refactor: merge emile + main branches
    [Interfaces.kicad_sch, PCB_GSE.kicad_sch, PCB_moteur.kicad_pcb, PowerSupply.kicad_sch, STM32_moteur.kicad_sch, Sensors.kicad_sch]
2026-02-01 fix: labels
    [Interfaces.kicad_sch, PCB_GSE.kicad_sch, PowerSupply.kicad_sch, Sensors.kicad_sch]
2026-02-01 fix: decoupling 3v3 missing
    [Interfaces.kicad_sch, PCB_GSE.kicad_sch, PowerSupply.kicad_sch]
2026-02-01 wip : Reduce BOM and fill all datasheet, digikey and MPN
    [Interfaces.kicad_sch, PCB_GSE.kicad_sch, PowerSupply.kicad_sch, Sensors.kicad_sch]
2026-02-02 wip: begining layout
    [Interfaces.kicad_sch, PCB_GSE.kicad_pcb, PCB_GSE.kicad_sch, PowerSupply.kicad_sch, Sensors.kicad_sch]
2026-02-02 wip: change in trace width
2026-02-02 wip: trace width
    [PCB_moteur.kicad_pcb]
2026-02-04 wip: changement trace width et début GND Via
    [PCB_moteur.kicad_pcb]
2026-02-04 wip: via
    [PCB_moteur.kicad_pcb]
2026-02-05 wip: GND vias et power polygon patching
    [PCB_moteur.kicad_pcb, Pyros.kicad_sch]
2026-02-05 wip: plane and 5V
    [PCB_moteur.kicad_pcb]
2026-02-06 feat: add 8MHz crystal, fix extended ios, fix pinout with HSE, update smt32 project, begin layout edge
    [830050510.step, Interfaces.kicad_sch, PCB_GSE.kicad_pcb, PCB_GSE.kicad_sch]
2026-02-06 feat(moteur): add 8MHz crystal (only schematic), fix ERC, update stm32 project, remove extend ios
    [Interfaces_moteur.kicad_sch, PCB_moteur.kicad_pcb, Pyros.kicad_sch, STM32_moteur.kicad_sch]
2026-02-07 chore: Change buck 12v
    [PowerSupply.kicad_sch, srr1208.stp]
2026-02-08 fix(GSE & Moteur): change Vin adc divider
    [PCB_GSE.kicad_pcb, PCB_moteur.kicad_pcb, PowerSupply.kicad_sch, Pyros.kicad_sch, Supply_moteur.kicad_sch]
2026-02-14 change 12V buck to 12V buck-boost
    [PCB_GSE.kicad_sch, PowerSupply.kicad_sch]
2026-02-14 wip : add BOM for 12V buck-boost
    [Interfaces.kicad_sch, PCB_GSE.kicad_sch, PowerSupply.kicad_sch]
2026-02-14 wip : subsystems layout
    [Interfaces.kicad_sch, PCB_GSE.kicad_pcb, PCB_GSE.kicad_sch, PowerSupply.kicad_sch, Sensors.kicad_sch]
2026-02-15 wip(gse): edge
    [PCB_GSE.kicad_pcb]
2026-02-15 wip(gse): begin layout
    [PCB_GSE.kicad_pcb]
2026-02-15 wip : finished layout and routing of powersupplys
    [PCB_GSE.kicad_pcb]
2026-02-15 wip : routing local circuits and power planes
    [Interfaces.kicad_sch, PCB_GSE.kicad_pcb, PCB_GSE.kicad_sch]
2026-02-15 fix(gse): stm32cubeide project import trames struct
    [CetautomatixGSE.ioc, comm.c, comm.h, comm_utils.c, comm_utils.h, main.c, main.h, protocol_defs.c]
2026-02-15 fix(gse & moteur): mapping + routing, remove CAN_ISO_IN/OUT
    [Interfaces.kicad_sch, Interfaces_moteur.kicad_sch, PCB_GSE.kicad_pcb, PCB_GSE.kicad_sch, PCB_moteur.kicad_pcb]
2026-02-16 wip : Done routing
    [PCB_GSE.kicad_pcb, PCB_GSE.kicad_sch, Sensors.kicad_sch]
2026-03-02 fix : replace valve 3 with servomotor on schematic
    [Interfaces.kicad_sch, PCB_GSE.kicad_sch]
2026-03-02 fix : replace Pressure sensor amplification circuit with new voltage divider circuit
    [PCB_GSE.kicad_sch, Sensors.kicad_sch]
2026-03-02 fix : routing des modifications Servo et capteur pression
    [Interfaces.kicad_sch, PCB_GSE.kicad_pcb, Sensors.kicad_sch]
2026-03-03 fix : done silkscreen and finition
    [Interfaces.kicad_sch, PCB_GSE.kicad_pcb, PCB_GSE.kicad_sch, PowerSupply.kicad_sch, Sensors.kicad_sch]
2026-03-03 wip: Cristal et modifs routing
    [PCB_moteur.kicad_pcb]
2026-03-04 wip: separation GND et modif schéma pression
    [PCB_moteur.kicad_pcb, Sensors.kicad_sch]
2026-03-04 wip: new pressure et fix alim
    [PCB_moteur.kicad_pcb, STM32_moteur.kicad_sch, Sensors.kicad_sch]
2026-03-04 wip : work on silkscreen and add all info to BOM
    [Interfaces_moteur.kicad_sch, PCB_moteur.kicad_pcb, Pyros.kicad_sch, STM32_moteur.kicad_sch, Sensors.kicad_sch, Supply_moteur.kicad_sch]
2026-03-04 wip : reorder refdes and fix footprints
    [Interfaces_moteur.kicad_sch, PCB_moteur.kicad_pcb, Pyros.kicad_sch, STM32_moteur.kicad_sch, Sensors.kicad_sch, Supply_moteur.kicad_sch]
2026-03-05 fix(gse): Vin servo
    [Interfaces.kicad_sch, PCB_GSE.kicad_pcb, PCB_GSE.kicad_sch, PowerSupply.kicad_sch, Sensors.kicad_sch]
2026-03-05 fix(moteur + gse): gnd not connected for pressure sensor + seperate alim pressure sensor for motor pcb
    [PCB_GSE.kicad_pcb, STM32_moteur.kicad_sch, Sensors.kicad_sch, Supply_moteur.kicad_sch]
2026-03-05 fix(gse): change Servo3_PWM -> TIM1_CH2, change Valve1/2_Open pin
    [PCB_GSE.kicad_pcb, PCB_GSE.kicad_sch, PowerSupply.kicad_sch]
2026-03-05 fix(moteur): remove Pressure_Sleep pin to stm32cubeide project
    [CetautomatixMoteur.ioc, main.c, main.h]
2026-03-05 fix : cap electrolytique servo
    [Interfaces.kicad_sch, PCB_GSE.kicad_pcb]
2026-03-05 wip: new alim, power plane and pin changes
    [PCB_moteur.kicad_pcb, Supply_moteur.kicad_sch]
2026-03-05 wip(moteur): traces
    [PCB_moteur.kicad_pcb, STM32_moteur.kicad_sch]
2026-03-06 wip: FINI DE CONNECTER LES NETS
    [PCB_moteur.kicad_pcb]
2026-03-06 wip: erreurs de DRC corrigées
    [PCB_moteur.kicad_pcb]
2026-03-06 fix : finished silkscreen finition
    [OSTVN04A150.STEP, PCB_moteur.kicad_pcb]
2026-03-07 fix: silkscreen green<->black + fix silkscreen + connect shield to gnd in pressure sensor + fix/add doc
    [Interfaces.kicad_sch, PCB_GSE.kicad_pcb, PowerSupply.kicad_sch, Sensors.kicad_sch]
2026-03-07 fix(moteur + gse): move xt30 to border + fix silkscreen + connect shield to gnd in pressure sensor + remake rounded corners + fix/add doc
    [Interfaces_moteur.kicad_sch, PCB_GSE.kicad_pcb, PCB_moteur.kicad_pcb, STM32_moteur.kicad_sch, Sensors.kicad_sch, Supply_moteur.kicad_sch]
2026-03-07 wip(moteur): reimport SI7617DN-T1-GE3 footprint + fix pads
    [PCB_moteur.kicad_pcb, Pyros.kicad_sch]
2026-03-07 wip(moteur + gse): fix silkscreen + traces + polygons
    [Interfaces.kicad_sch, PCB_GSE.kicad_pcb, PCB_moteur.kicad_pcb]
2026-03-07 wip(moteur): add jack connector + fix dump valve
    [Interfaces_moteur.kicad_sch, PCB_moteur.kicad_pcb, PJ-037BH.step]
2026-03-07 Fix : connect all nets and fix dump valve kill
    [Interfaces_moteur.kicad_sch, PCB_moteur.kicad_pcb]
2026-03-07 Fix : servo side connectors
    [Interfaces.kicad_sch, Interfaces_moteur.kicad_sch, PCB_GSE.kicad_pcb, PCB_moteur.kicad_pcb]
2026-03-08 fix : add polyfuses and fix 90 deg servo connectors
    [Interfaces_moteur.kicad_sch, PCB_GSE.csv, PCB_moteur.kicad_pcb, PowerSupply.kicad_sch, SM03B-GHS-TB.step, Supply_moteur.kicad_sch]
2026-03-08 fix : BOM errors, change cutoff freq for moteur, minor fixes for GSE
    [Interfaces_moteur.kicad_sch, PCB_GSE.kicad_pcb, PCB_moteur.kicad_pcb, Pyros.kicad_sch, STM32_moteur.kicad_sch, Sensors.kicad_sch, Supply_moteur.kicad_sch]
2026-03-08 chore: clean up the pcb and optimize some routings
    [PCB_moteur.kicad_pcb]
2026-03-08 fix(gse): Vin trace
    [PCB_GSE.kicad_pcb]
2026-03-09 feature : Done v1 and send to fab
    [Interfaces.kicad_sch, Interfaces_moteur.kicad_sch, PCB_GSE.kicad_pcb, PCB_GSE.kicad_sch, PCB_moteur.kicad_pcb, PowerSupply.kicad_sch, Sensors.kicad_sch, Supply_moteur.kicad_sch]
2026-03-09 fix(gse): change Swahelok S model -> Swagelok A model (adaptable) + 100R -> 100R 1% + silkscreen
    [PCB_GSE.kicad_pcb, PCB_GSE.kicad_sch, Sensors.kicad_sch]
2026-03-09 fix(moteur): change Swahelok S model -> Swagelok A model (adaptable) + 100R -> 100R 1% + silkscreen
    [PCB_moteur.kicad_pcb, STM32_moteur.kicad_sch, Sensors.kicad_sch]
2026-03-10 fix(moteur): mosfet pyros pads
    [PCB_moteur.kicad_pcb, Pyros.kicad_sch]
2026-03-10 fabrication v2
    [PCB_moteur.kicad_pcb]
2026-03-15 refactor: trame -> GSE
    main loop missing + received behavior missing
    [GAUL_trames.ioc, can.c, comm.c, comm.h, comm_tx.c, comm_tx.h, comm_utils.c]
2026-03-15 feat!: add uart dma + ring buffer + uart interrupt + can rx interrupt + add logs in gse->sas frame & motor->gse frame + refactor can in seperated files + add clock ioc configuratio + add ioc uart + c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
2026-03-16 fix!(gse): can 9 bytes receptions + use ring buffer
    [can_fifo.c, can_fifo.h, comm.c]
2026-03-16 fix(gse): thrut_loadcell + ring buffer optimisation + fix 9bytes gse<-motor pack + add uart tx dma + add verifs
    [CetautomatixGSE.ioc, can_fifo.c, comm.c, comm.h, frame_defs.c, main.c, ring_buffer.c]
2026-03-16 fix(gse): bad return UART_DMA_Start
    [uart_dma.c]
2026-03-16 feat(gse): add crtiticalLED + begin buck 12v
2026-03-16 feat: add mp28167 12v buck
2026-03-17 feat: add adc dual reading with extend dma + add converted pression/load cell + add tare functions for pression/load cell + move into lowlevel folder
2026-03-17 chore: add typo frame
2026-03-17 refactor: GAUL_Drivers->GAUL/Drivers
2026-03-23 feat(gse): add servo/solenoid driver + fix adc_dual init
    [adc_dual.c, adc_dual.h, control_valves.c, control_valves.h]
2026-03-23 fix(gse): fix trame typo
    [frame_defs.c]
2026-03-24 feat(gse): add watchdog driver
