GAULAvionique/Cetautomatix/(notices)

Notices in the files:
Software/STM32CubeIDE/Moteur/Core/Inc/main.h:
Copyright (c) 2026 STMicroelectronics.
All rights reserved.
This software is licensed under terms that can be found in the LICENSE file
Software/STM32CubeIDE/trames/Core/Src/main.c:
Copyright (c) 2025 STMicroelectronics.
